Riddick-ulous/DICV3/Firmware/Notes.txt

Datenlogging SPI funktioniert nur bis commit bevor Realtime implementation angefangen hat
