Riddick-ulous/DICV3/Dokumentation/Snipaste_2025-02-16_13-41-41.png

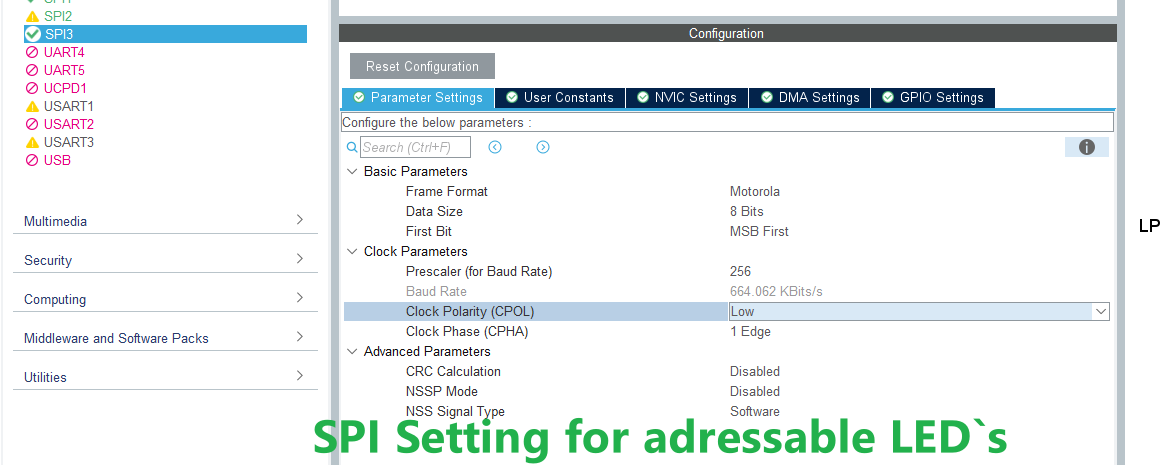
Dokumentation/Snipaste_2025-02-16_13-41-41.png
