Riddick-ulous/DICV3/MCAD/DICMainboard.FCStd

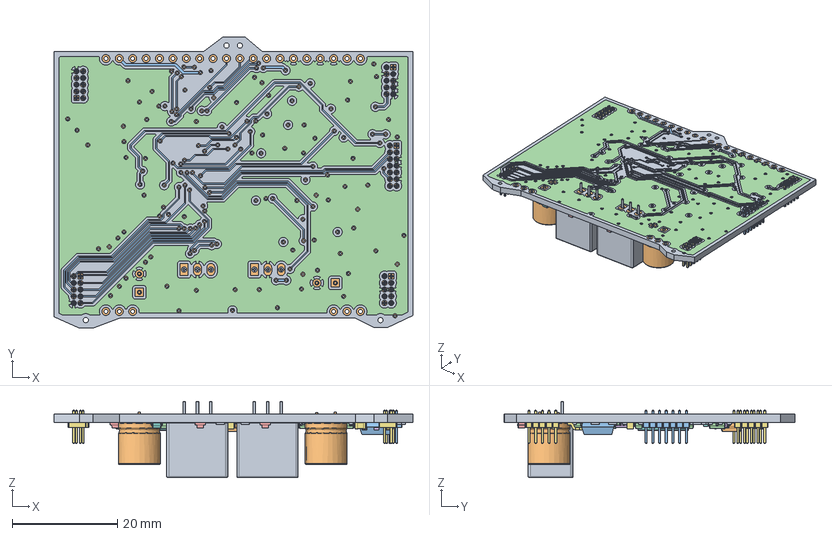
[picture p2: CAD file, 2025-03-25]
MCAD/DICMainboard.FCStd
68.1 x 55.2 x 14.5 mm
Pcb_e9e
topPads_e9e
topTracks_e9e
topZones_e9e
botPads_e9e
botTracks_e9e
C19_C_0805_2012Metric_915db11c73f1 x 11
C18_C_0603_1608Metric_10e447ca614a x 18
R42_R_0603_1608Metric_e00ced120b5b x 47
C21_CP_Radial_D80mm_P350mm_b4bb79b80bd8 x 2
JTAG1_PinHeader_2x07_P127mm_Vertical_7ea92a9874db
U2_SOT_23_5143090a7d01 x 9
12VGood1_LED_0805_2012Metric_2ad75f4ca093 x 5
U10_MSOP_8_3x3mm_P065mm_82bb67e16242 x 2
J3_PinHeader_2x05_P127mm_Vertical_4a0e541a8516 x 4
D10_D_SOD_323_1cf1e5386782 x 7
U1_Converter_DCDC_RECOM_R_78E_05_THT_7495ffbcc0e0 x 2
U7_SOIC_8_39x49mm_P127mm_1499a48e6e93
932d09b3-9c39-11ed-93f0-dde97e994e83_part
932d09b4-9c39-11ed-93f0-dde97e994e83_part
932d09b5-9c39-11ed-93f0-dde97e994e83_part
932d09b5-9c39-11ed-93f0-dde97e994e83_part001
932d09b5-9c39-11ed-93f0-dde97e994e83_part002
U3_LQFP_64_10x10mm_P05mm_ad08613fb525
