Riddick-ulous/DICV3/MCAD/Resources/DIC_Addon.step

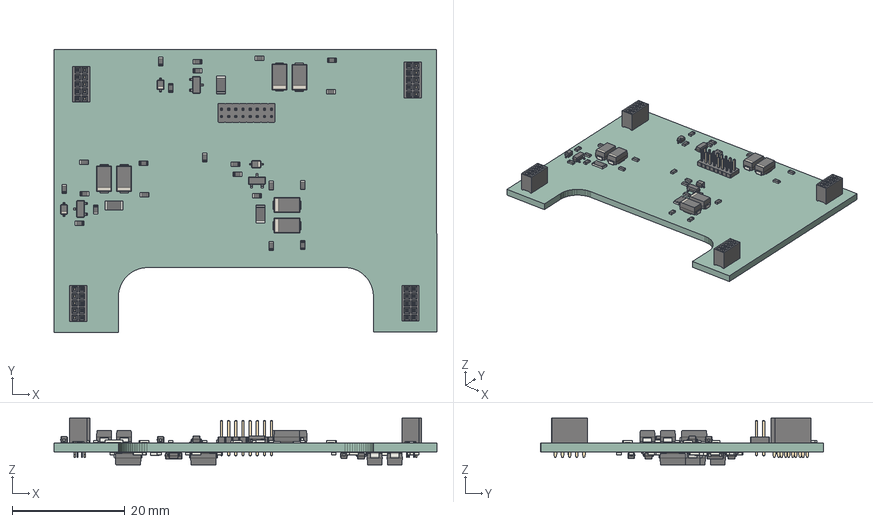
[picture p4: CAD file, 2025-03-25]
MCAD/Resources/DIC_Addon.step
67.9 x 50.3 x 8.32 mm
SOT_23 x 6
D_SOD_323 x 6
PinSocket_2x05_P127mm_Vertical x 4
R_0603_1608Metric x 42
D_SMA x 12
PinHeader_2x08_P127mm_Vertical
R_1206_3216Metric x 6
DIC_Addon PCB
