Riddick-ulous/DICV3/MCAD/ConnectorInterfaceBoard.FCStd

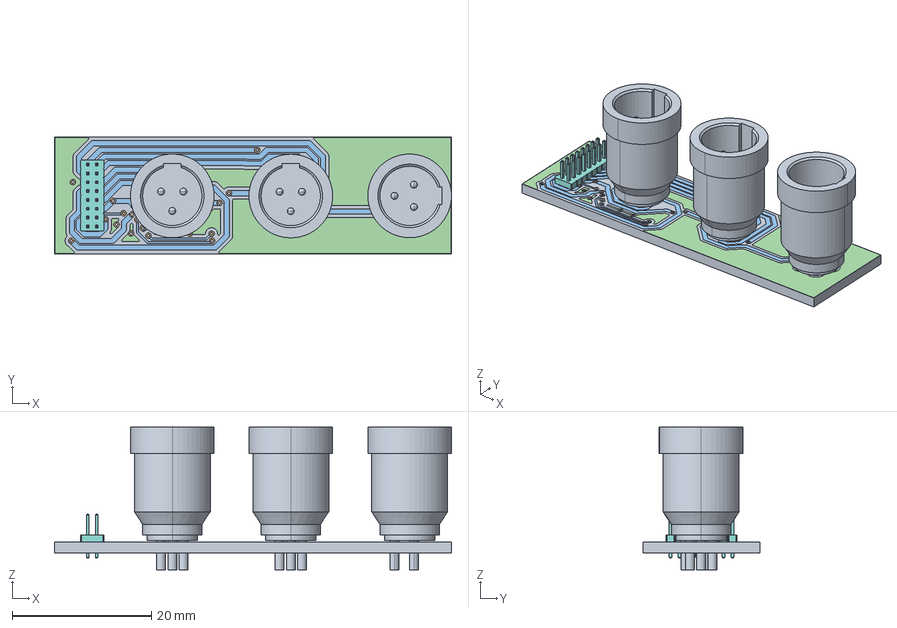
[picture p5: CAD file, 2025-04-17]
MCAD/ConnectorInterfaceBoard.FCStd
56.9 x 16.8 x 20.5 mm
Pcb_5996
topPads_5996
topTracks_5996
topZones_5996
botPads_5996
botTracks_5996
botZones_5996
J4_PinHeader_2x08_P127mm_Vertical_934e7c050846
J1_RT3MP_764b897103e7 x 3
