Riddick-ulous/DICV3/MCAD/Resources/LED_Ring.step

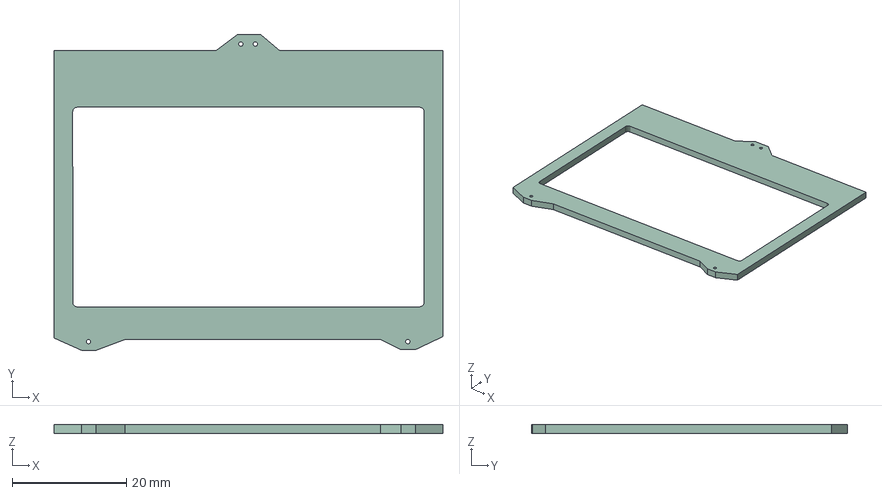
[picture p6: CAD file, 2025-03-22]
MCAD/Resources/LED_Ring.step
68.1 x 55.2 x 1.60 mm
