Riddick-ulous/DICV3/ECAD/DIC_Addon/DIC_Addon2_union.FCStd

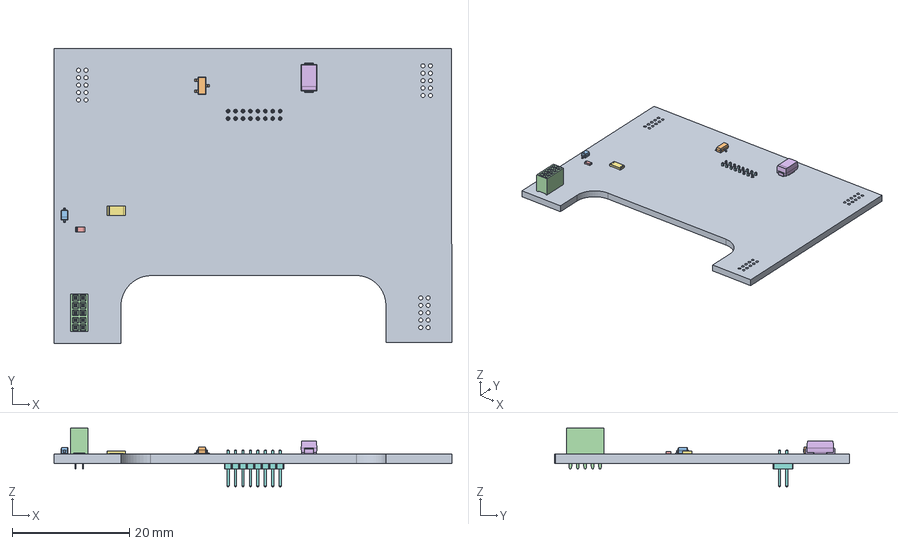
[picture p7: CAD file, 2025-03-25]
ECAD/DIC_Addon/DIC_Addon2_union.FCStd
67.9 x 50.3 x 10.0 mm
Pcb_25db
Q6_SOT_23_ffd5320711a5
D16_D_SOD_323_d7651d96f6c3
J6_PinSocket_2x05_P127mm_Vertical_83ee9fbb584e
R41_R_0603_1608Metric_127fa2614279
D6_D_SMA_735d77270f2b
TH6_R_1206_3216Metric_a4174fc2a386
J3_PinHeader_2x08_P127mm_Vertical_13ff719d442c
