Riddick-ulous/DICV3/MCAD/DICAddonBoard.FCStd

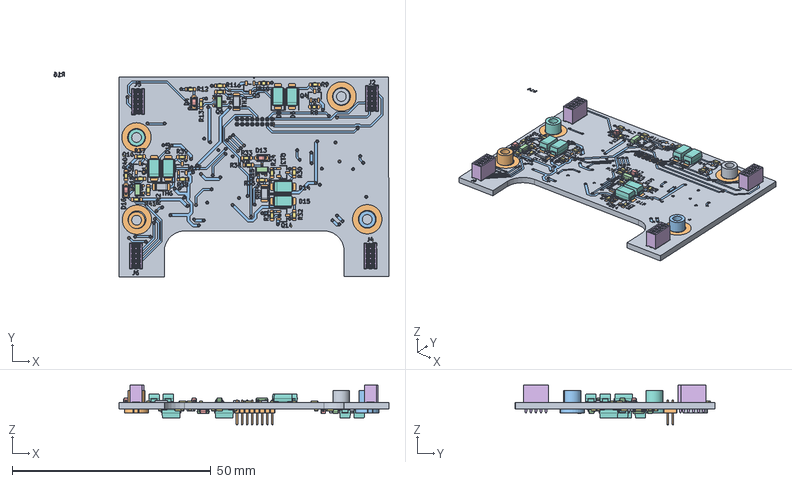
[picture p8: CAD file, 2025-04-17]
MCAD/DICAddonBoard.FCStd
84.2 x 51.5 x 10.0 mm
Pcb_25db
topPads_25db
topTracks_25db
botPads_25db
botTracks_25db
botSilks_c76e
topSilks_caba
Q6_SOT_23_ffd5320711a5 x 6
D16_D_SOD_323_d7651d96f6c3 x 6
J6_PinSocket_2x05_P127mm_Vertical_83ee9fbb584e x 4
R41_R_0603_1608Metric_127fa2614279 x 42
D6_D_SMA_735d77270f2b x 12
TH6_R_1206_3216Metric_a4174fc2a386 x 6
J3_PinHeader_2x08_P127mm_Vertical_13ff719d442c
