Riddick-ulous/DICV3/MCAD/DICDispalyBoard.FCStd

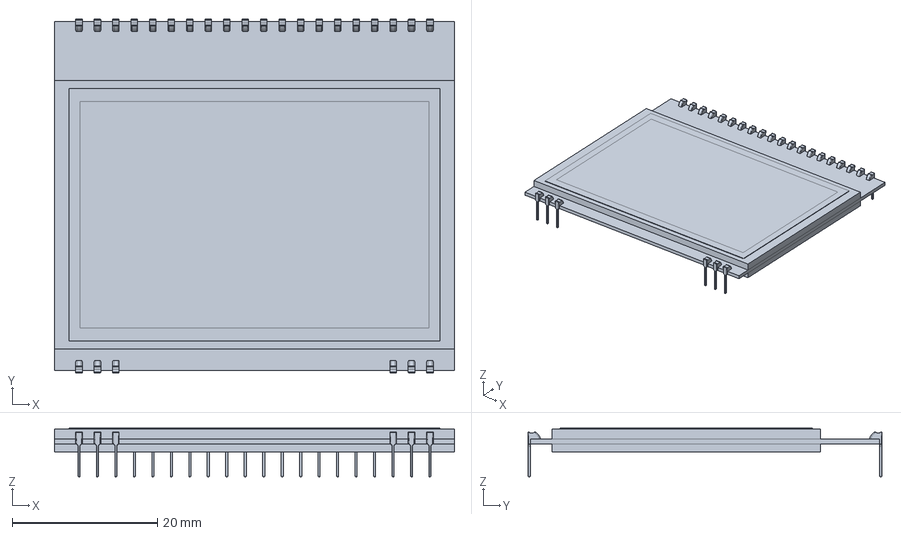
[picture p9: CAD file, 2025-03-22]
MCAD/DICDispalyBoard.FCStd
55.0 x 48.7 x 6.70 mm
