Riddick-ulous/DICV3/(list of files, cad)

Other CAD files:
MCAD/DisplayAssembly.FCStd
ECAD/DIC_Addon/DIC_Addon.step
MCAD/DICLEDBoard.FCStd
ECAD/DIC_Addon/DIC_Addon.FCStd
ECAD/DIC_Addon/DIC_Addon1.FCStd
