Riddick-ulous/DICV3/Dokumentation/AnalogFrontend.asc

C1: cap; 160n
C2: cap; 160n
D1: schottky; BAT54
D2: schottky; BAT54
Q1: npn
Q2: npn
Q3: npn
Q4: npn
R1: res; 82k
R2: res; 150k
R3: res; 39k
R4: res; 1k
R5: res; 100
R6: res; 100
R7: res; 100
R8: res; 6800
R9: res; 2.2Mega
R10: res; 82k
R11: res; 150k
R12: res; 1k
R13: res; 39k
R14: res; 100
R15: res; 100
R16: res; 100
R17: res; 2.2Mega
R18: res; 5k
R19: res; 5k
U1: ADA4500
U2: ADA4500
V1: voltage; 5
V2: voltage; -5
V3: voltage; 12
V4: voltage; 3.3
V5: voltage; 3.3
V6: voltage; 3.3
V7: voltage; 5
V8: voltage; -5
V9: voltage; 3.3
V10: voltage; 3.3
V11: voltage; 3.3
V12: voltage; SINE(6 6 1000)
V13: voltage; 0
V14: voltage; 3.3
Named nets: 0
.tran 0.005
