Riddick-ulous/DICV3/ECAD/DIC/DIC.kicad_pcb

## KiCad design ECAD/DIC/DIC.kicad_pcb (2025-06-22)

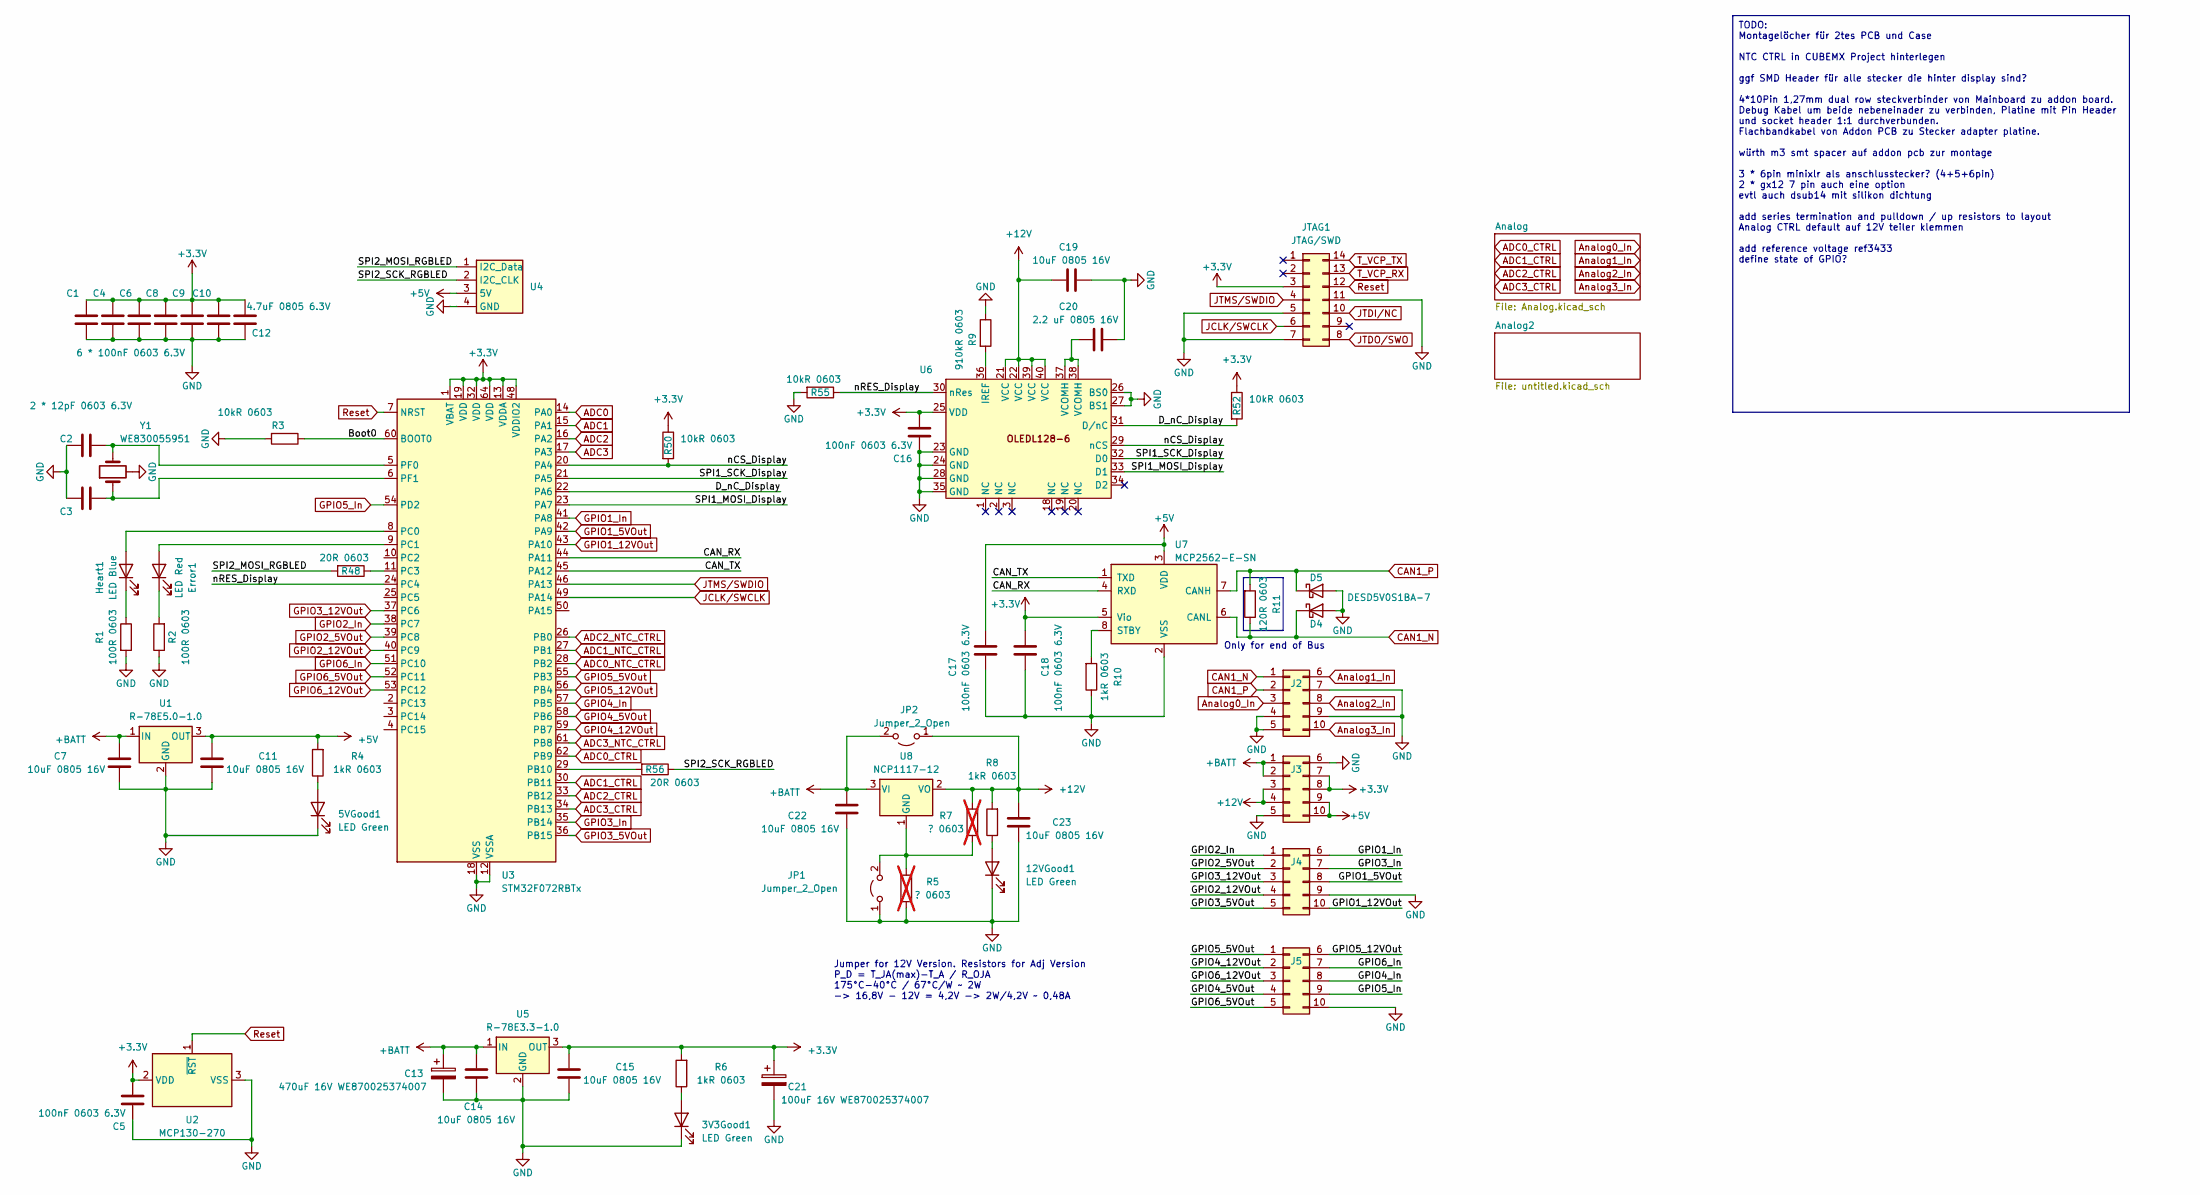
[picture p10: schematic DIC.kicad_sch]

Parts:
3V3Good1, 5VGood1, 12VGood1: LED Green; LED_0805_2012Metric_Pad1.15x1.40mm_HandSolder
C1, C4, C5, C6, C8, C10, C16, C17, C18: 100nF 0603 6.3V; C_0603_1608Metric_Pad1.08x0.95mm_HandSolder
C2: 12pF 0603 6.3V; C_0603_1608Metric_Pad1.08x0.95mm_HandSolder
C3: 2 * 12pF 0603 6.3V; C_0603_1608Metric_Pad1.08x0.95mm_HandSolder
C7, C11, C14, C15, C19, C22, C23: 10uF 0805 16V; C_0805_2012Metric_Pad1.18x1.45mm_HandSolder
C9: 6 * 100nF 0603 6.3V; C_0603_1608Metric_Pad1.08x0.95mm_HandSolder
C12: 4.7uF 0805 6.3V; C_0805_2012Metric_Pad1.18x1.45mm_HandSolder
C13: 470uF 16V WE870025374007; CP_Radial_D8.0mm_P3.50mm
C20: 2.2 uF 0805 16V; C_0805_2012Metric_Pad1.18x1.45mm_HandSolder
C21: 100uF 16V WE870025374007; CP_Radial_D8.0mm_P3.50mm
D4, D5: DESD5V0S1BA-7; D_SOD-323
Error1: LED Red; LED_0805_2012Metric_Pad1.15x1.40mm_HandSolder
Heart1: LED Blue; LED_0805_2012Metric_Pad1.15x1.40mm_HandSolder
J2, J3, J4, J5: Conn_02x05_Top_Bottom; PinHeader_2x05_P1.27mm_Vertical
JP1, JP2: Jumper_2_Open; SolderJumper-2_P1.3mm_Open_RoundedPad1.0x1.5mm
JTAG1: JTAG/SWD; PinHeader_2x07_P1.27mm_Vertical
R1, R2: 100R 0603; R_0603_1608Metric_Pad0.98x0.95mm_HandSolder
R3, R50, R52, R55: 10kR 0603; R_0603_1608Metric_Pad0.98x0.95mm_HandSolder
R4, R6, R8, R10: 1kR 0603; R_0603_1608Metric_Pad0.98x0.95mm_HandSolder
R5, R7: ? 0603; R_0603_1608Metric_Pad0.98x0.95mm_HandSolder; not fitted
R9: 910kR 0603; R_0603_1608Metric_Pad0.98x0.95mm_HandSolder
R11: 120R 0603; R_0603_1608Metric_Pad0.98x0.95mm_HandSolder
R48, R56: 20R 0603; R_0603_1608Metric_Pad0.98x0.95mm_HandSolder
U1: R-78E5.0-1.0; Converter_DCDC_RECOM_R-78E-0.5_THT
U2: MCP130-270; SOT-23
U3: STM32F072RBTx; LQFP-64_10x10mm_P0.5mm
U4: LED_Ring
U5: R-78E3.3-1.0; Converter_DCDC_RECOM_R-78E-0.5_THT
U6: EA OLEDL128-6
U7: MCP2562-E-SN; SOIC-8_3.9x4.9mm_P1.27mm
U8: NCP1117-12; TO-252-2
Y1: WE830055951; Oscillator_SMD_EuroQuartz_XO32-4Pin_3.2x2.5mm_HandSoldering

Connections:
+3.3V: C1.1, C4.1, C5.2, C6.1, C8.1, C9.1, C10.1, C12.1, C15.1, C16.2, C18.2, C21.1, J3.7, J3.8, JTAG1.3, R6.2, R50.1, R52.1, U2.2 (VDD), U3.1 (VBAT), U3.13 (VDDA), U3.19 (VDD), U3.32 (VDD), U3.48 (VDDIO2), U3.64 (VDD), U5.3 (OUT), U6.25 (VDD), U7.5 (Vio); also elsewhere on the board
+5V: C11.1, C17.2, J3.9, J3.10, R4.2, U1.3 (OUT), U4.3 (5V), U7.3 (VDD); also elsewhere on the board
+12V: C19.2, C23.1, J3.3, J3.4, JP2.1 (A), R7.2, R8.2, U6.21 (VCC), U6.22 (VCC), U6.39 (VCC), U6.40 (VCC), U8.2 (VO)
+BATT: C7.1, C13.1, C14.1, C22.1, J3.1, J3.2, JP2.2 (B), U1.1 (IN), U5.1 (IN), U8.3 (VI)
/Boot0: R3.1, U3.60 (BOOT0)
/CAN_RX: U3.44 (PA11), U7.4 (RXD)
/CAN_TX: U3.45 (PA12), U7.1 (TXD)
/D_nC_Display: R52.2, U3.22 (PA6), U6.31 (D/nC)
/SPI1_MOSI_Display: U3.23 (PA7), U6.33 (D1)
/SPI1_SCK_Display: U3.21 (PA5), U6.32 (D0)
/SPI2_MOSI_RGBLED: R48.2, U4.1 (I2C_Data)
/SPI2_SCK_RGBLED: R56.1, U4.2 (I2C_CLK)
/nCS_Display: R50.2, U3.20 (PA4), U6.29 (nCS)
/nRES_Display: R55.1, U3.24 (PC4), U6.30 (nRes)
ADC0: U3.14 (PA0); also elsewhere on the board
ADC0_CTRL: U3.62 (PB9); also elsewhere on the board
ADC0_NTC_CTRL: U3.28 (PB2); also elsewhere on the board
ADC1: U3.15 (PA1); also elsewhere on the board
ADC1_CTRL: U3.30 (PB11); also elsewhere on the board
ADC1_NTC_CTRL: U3.27 (PB1); also elsewhere on the board
ADC2: U3.16 (PA2); also elsewhere on the board
ADC2_CTRL: U3.33 (PB12); also elsewhere on the board
ADC2_NTC_CTRL: U3.26 (PB0); also elsewhere on the board
ADC3: U3.17 (PA3); also elsewhere on the board
ADC3_CTRL: U3.34 (PB13); also elsewhere on the board
ADC3_NTC_CTRL: U3.61 (PB8); also elsewhere on the board
Analog0_In: J2.3; also elsewhere on the board
Analog1_In: J2.6; also elsewhere on the board
Analog2_In: J2.8; also elsewhere on the board
Analog3_In: J2.10; also elsewhere on the board
CAN1_N: D4.1 (K), J2.1, R11.1, U7.6 (CANL)
CAN1_P: D5.1 (K), J2.2, R11.2, U7.7 (CANH)
GND: 3V3Good1.1 (K), 5VGood1.1 (K), 12VGood1.1 (K), C1.2, C2.1, C3.1, C4.2, C5.1, C6.2, C7.2, C8.2, C9.2, C10.2, C11.2, C12.2, C13.2, C14.2, C15.2, C16.1, C17.1, C18.1, C19.1, C20.1, C21.2, C22.2, C23.2, D4.2 (A), D5.2 (A), J2.4, J2.5, J2.7, J2.9, J3.5, J3.6, J4.9, J5.10, JP1.1 (A), JTAG1.5, JTAG1.7, JTAG1.11, R1.2, R2.1, R3.2, R5.1, R9.1, R10.1, R55.2, U1.2 (GND), U2.3 (VSS), U3.12 (VSSA), U3.18 (VSS), U3.31 (VSS), U3.47 (VSS), U3.63 (VSS), U4.4 (GND), U5.2 (GND), U6.23 (GND), U6.24 (GND), U6.26 (BS0), U6.27 (BS1), U6.28 (GND), U6.35 (GND), U7.2 (VSS), Y1.2 (2_GND), Y1.4 (4_GND); also elsewhere on the board
GPIO1_5VOut: J4.8, U3.42 (PA9)
GPIO1_12VOut: J4.10, U3.43 (PA10)
GPIO1_In: J4.6, U3.41 (PA8)
GPIO2_5VOut: J4.2, U3.39 (PC8)
GPIO2_12VOut: J4.4, U3.40 (PC9)
GPIO2_In: J4.1, U3.38 (PC7)
GPIO3_5VOut: J4.5, U3.36 (PB15)
GPIO3_12VOut: J4.3, U3.37 (PC6)
GPIO3_In: J4.7, U3.35 (PB14)
GPIO4_5VOut: J5.4, U3.58 (PB6)
GPIO4_12VOut: J5.2, U3.59 (PB7)
GPIO4_In: J5.8, U3.57 (PB5)
GPIO5_5VOut: J5.1, U3.55 (PB3)
GPIO5_12VOut: J5.6, U3.56 (PB4)
GPIO5_In: J5.9, U3.54 (PD2)
GPIO6_5VOut: J5.5, U3.52 (PC11)
GPIO6_12VOut: J5.3, U3.53 (PC12)
GPIO6_In: J5.7, U3.51 (PC10)
JCLK/SWCLK: JTAG1.6, U3.49 (PA14)
JTDI/NC: JTAG1.10
JTDO/SWO: JTAG1.8
JTMS/SWDIO: JTAG1.4, U3.46 (PA13)
unnamed: 3V3Good1.2 (A), R6.1
unnamed: 5VGood1.2 (A), R4.1
unnamed: 12VGood1.2 (A), R8.1
unnamed: C20.2, U6.37 (VCOMH), U6.38 (VCOMH)
unnamed: Error1.2 (A), U3.9 (PC1)
unnamed: Error1.1 (K), R2.2
unnamed: Heart1.2 (A), U3.8 (PC0)
unnamed: Heart1.1 (K), R1.1
unnamed: JP1.2 (B), R5.2, R7.1, U8.1 (GND)
unnamed: R56.2, U3.29 (PB10)
unnamed: R48.1, U3.11 (PC3)
unnamed: C2.2, U3.5 (PF0), Y1.3 (3_Crystal)
unnamed: C3.2, U3.6 (PF1), Y1.1 (1_Crystal)
unnamed: R9.2, U6.36 (IREF)
unnamed: R10.2, U7.8 (STBY)
Reset: JTAG1.12, U2.1 (~RST), U3.7 (NRST)
T_VCP_RX: JTAG1.13
T_VCP_TX: JTAG1.14

Notes on the sheet:
TODO: Montagelöcher für 2tes PCB und Case NTC CTRL in CUBEMX Project hinterlegen ggf SMD Header für alle stecker die hinter display sind? 4*10Pin 1,27mm dual row steckverbinder von Mainboard zu addon board. Debug Kabel um beide nebeneinader zu verbinden, Platine mit Pin Header und socket header 1:1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
Only for end of Bus
Jumper for 12V Version. Resistors for Adj Version P_D = T_JA(max)-T_A / R_OJA 175°C-40°C / 67°C/W ~ 2W -> 16,8V - 12V = 4,2V -> 2W/4,2V ~ 0,48A

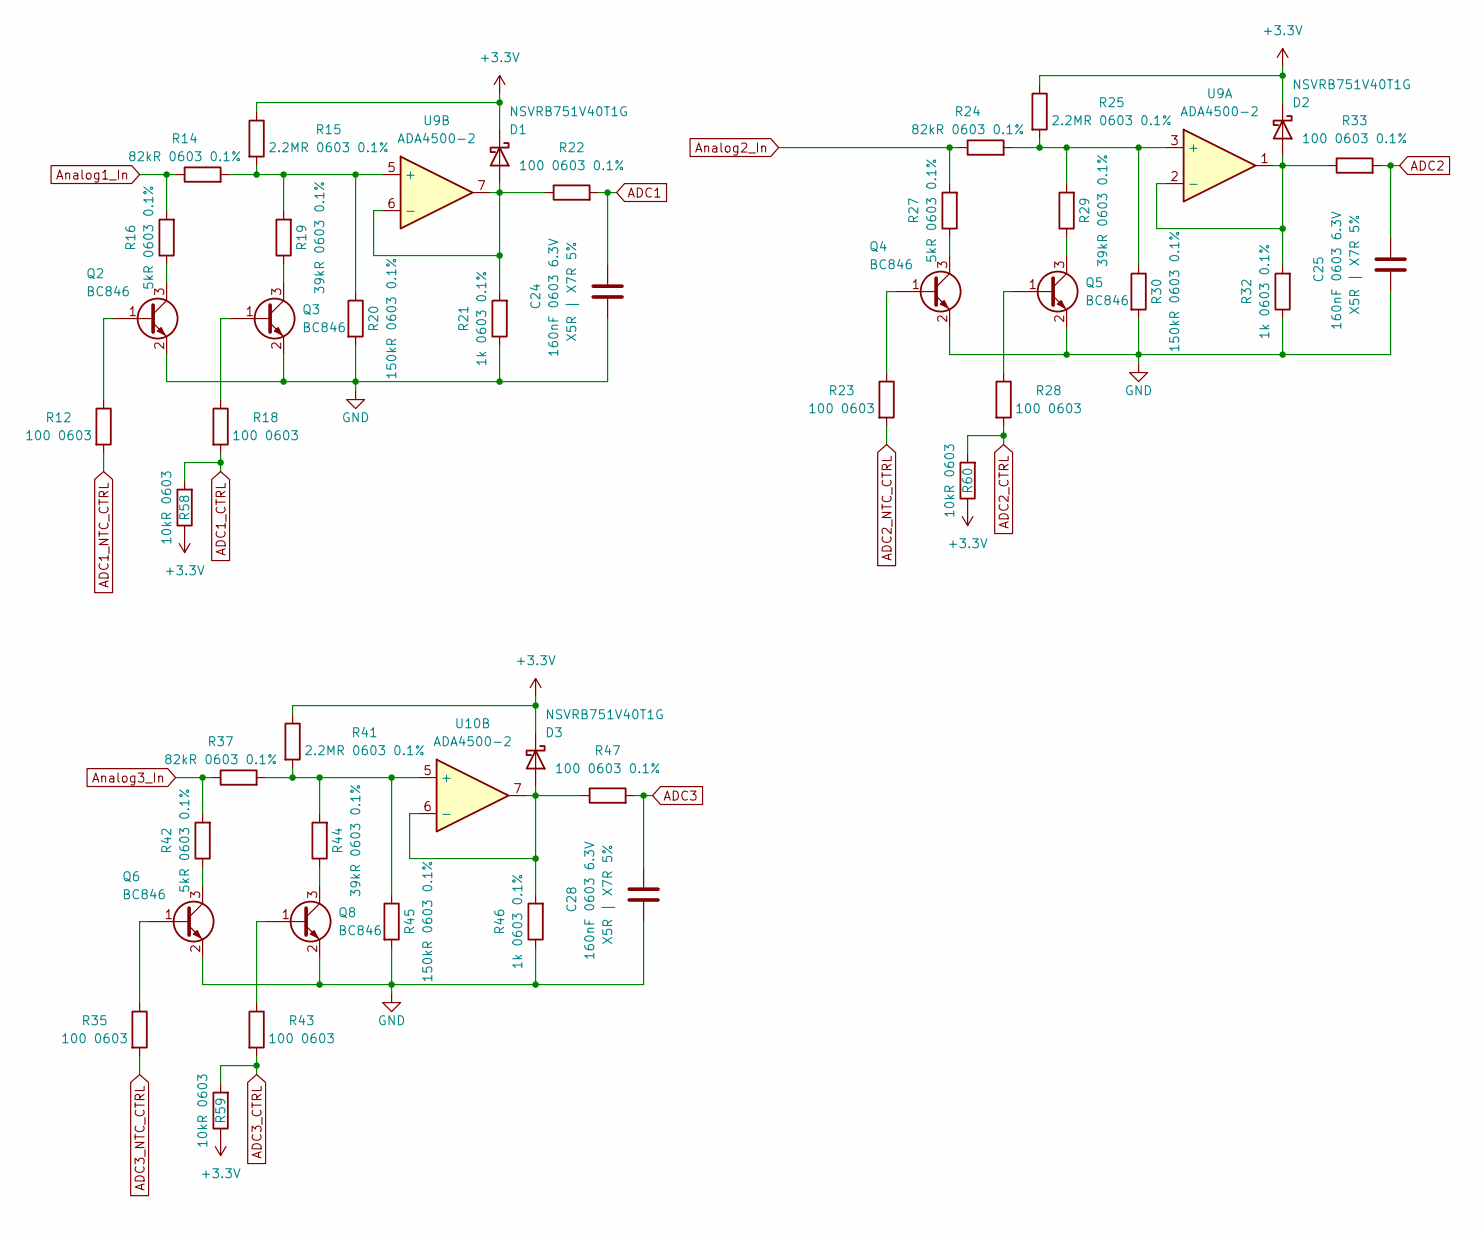
[picture p11: schematic untitled.kicad_sch]

Parts:
C24, C25, C28: 160nF 0603 6.3V; C_0603_1608Metric_Pad1.08x0.95mm_HandSolder; PartNr. VJ0603Y223JXJAC
D1, D2, D3: NSVRB751V40T1G; D_SOD-323_HandSoldering; PartNr. NSVRB751V40T1G
Q2, Q3, Q4, Q5, Q6, Q8: BC846; SOT-23
R12, R18, R23, R28, R35, R43: 100 0603; R_0603_1608Metric_Pad0.98x0.95mm_HandSolder
R14, R24, R37: 82kR 0603 0.1%; R_0603_1608Metric_Pad0.98x0.95mm_HandSolder
R15, R25, R41: 2.2MR 0603 0.1%; R_0603_1608Metric_Pad0.98x0.95mm_HandSolder
R16, R27, R42: 5kR 0603 0.1%; R_0603_1608Metric_Pad0.98x0.95mm_HandSolder
R19, R29, R44: 39kR 0603 0.1%; R_0603_1608Metric_Pad0.98x0.95mm_HandSolder
R20, R30, R45: 150kR 0603 0.1%; R_0603_1608Metric_Pad0.98x0.95mm_HandSolder
R21, R32, R46: 1k 0603 0.1%; R_0603_1608Metric_Pad0.98x0.95mm_HandSolder
R22, R33, R47: 100 0603 0.1%; R_0603_1608Metric_Pad0.98x0.95mm_HandSolder
R58, R59, R60: 10kR 0603; R_0603_1608Metric_Pad0.98x0.95mm_HandSolder
U9, U10: ADA4500-2; MSOP-8_3x3mm_P0.65mm

Connections:
+3.3V: D1.1 (K), D2.1 (K), D3.1 (K), R15.1, R25.1, R41.1, R58.1, R59.1, R60.1; also elsewhere on the board
ADC1: C24.2, R22.2; also elsewhere on the board
ADC1_CTRL: R18.2, R58.2; also elsewhere on the board
ADC1_NTC_CTRL: R12.2; also elsewhere on the board
ADC2: C25.2, R33.2; also elsewhere on the board
ADC2_CTRL: R28.2, R60.2; also elsewhere on the board
ADC2_NTC_CTRL: R23.2; also elsewhere on the board
ADC3: C28.2, R47.2; also elsewhere on the board
ADC3_CTRL: R43.2, R59.2; also elsewhere on the board
ADC3_NTC_CTRL: R35.2; also elsewhere on the board
Analog1_In: R14.1, R16.2; also elsewhere on the board
Analog2_In: R24.1, R27.2; also elsewhere on the board
Analog3_In: R37.1, R42.2; also elsewhere on the board
GND: C24.1, C25.1, C28.1, Q2.2 (E), Q3.2 (E), Q4.2 (E), Q5.2 (E), Q6.2 (E), Q8.2 (E), R20.2, R21.1, R30.2, R32.1, R45.2, R46.1; also elsewhere on the board
unnamed: D1.2 (A), R21.2, R22.1, U9.6 (-), U9.7
unnamed: D2.2 (A), R32.2, R33.1, U9.1, U9.2 (-)
unnamed: D3.2 (A), R46.2, R47.1, U10.6 (-), U10.7
unnamed: Q2.1 (B), R12.1
unnamed: Q2.3 (C), R16.1
unnamed: Q3.1 (B), R18.1
unnamed: Q3.3 (C), R19.1
unnamed: Q4.1 (B), R23.1
unnamed: Q4.3 (C), R27.1
unnamed: Q5.1 (B), R28.1
unnamed: Q5.3 (C), R29.1
unnamed: Q6.1 (B), R35.1
unnamed: Q6.3 (C), R42.1
unnamed: Q8.1 (B), R43.1
unnamed: Q8.3 (C), R44.1
unnamed: R24.2, R25.2, R29.2, R30.1, U9.3 (+)
unnamed: R14.2, R15.2, R19.2, R20.1, U9.5 (+)
unnamed: R37.2, R41.2, R44.2, R45.1, U10.5 (+)

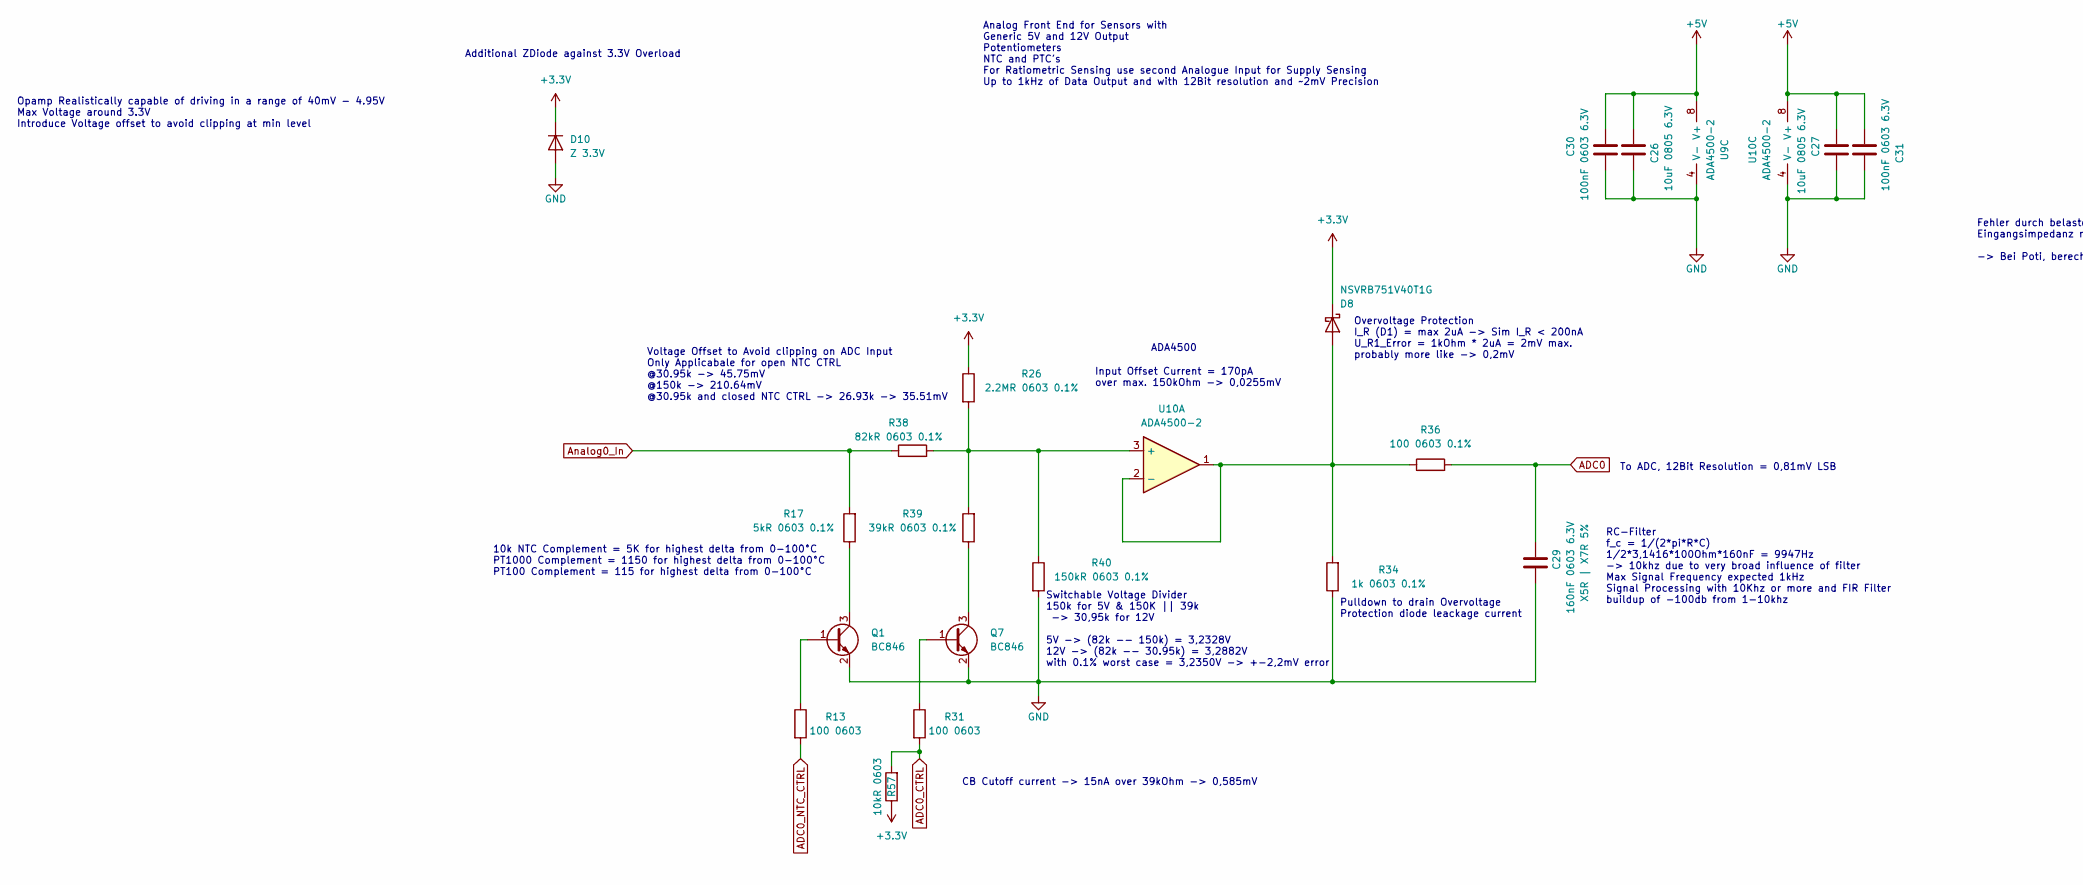
[picture p12: schematic Analog.kicad_sch, part in row 1, column 1]

Parts:
C26, C27: 10uF 0805 6.3V; C_0805_2012Metric_Pad1.18x1.45mm_HandSolder
C29: 160nF 0603 6.3V; C_0603_1608Metric_Pad1.08x0.95mm_HandSolder; PartNr. VJ0603Y223JXJAC
C30, C31: 100nF 0603 6.3V; C_0603_1608Metric_Pad1.08x0.95mm_HandSolder
D8: NSVRB751V40T1G; D_SOD-323_HandSoldering; PartNr. NSVRB751V40T1G
D10: Z 3.3V; D_SOD-323_HandSoldering; PartNr. MM3Z3V3T1G
Q1, Q7: BC846; SOT-23
R13, R31: 100 0603; R_0603_1608Metric_Pad0.98x0.95mm_HandSolder
R17: 5kR 0603 0.1%; R_0603_1608Metric_Pad0.98x0.95mm_HandSolder
R26: 2.2MR 0603 0.1%; R_0603_1608Metric_Pad0.98x0.95mm_HandSolder
R34: 1k 0603 0.1%; R_0603_1608Metric_Pad0.98x0.95mm_HandSolder
R36: 100 0603 0.1%; R_0603_1608Metric_Pad0.98x0.95mm_HandSolder
R38: 82kR 0603 0.1%; R_0603_1608Metric_Pad0.98x0.95mm_HandSolder
R39: 39kR 0603 0.1%; R_0603_1608Metric_Pad0.98x0.95mm_HandSolder
R40: 150kR 0603 0.1%; R_0603_1608Metric_Pad0.98x0.95mm_HandSolder
R57: 10kR 0603; R_0603_1608Metric_Pad0.98x0.95mm_HandSolder
U9, U10: ADA4500-2; MSOP-8_3x3mm_P0.65mm

Connections:
+3.3V: D8.1 (K), D10.1 (K), R26.1, R57.1; also elsewhere on the board
+5V: C26.1, C27.2, C30.2, C31.1, U9.8 (V+), U10.8 (V+); also elsewhere on the board
ADC0: C29.2, R36.2; also elsewhere on the board
ADC0_CTRL: R31.2, R57.2; also elsewhere on the board
ADC0_NTC_CTRL: R13.2; also elsewhere on the board
Analog0_In: R17.2, R38.1; also elsewhere on the board
GND: C26.2, C27.1, C29.1, C30.1, C31.2, D10.2 (A), Q1.2 (E), Q7.2 (E), R34.1, R40.2, U9.4 (V-), U10.4 (V-); also elsewhere on the board
unnamed: D8.2 (A), R34.2, R36.1, U10.1, U10.2 (-)
unnamed: Q1.1 (B), R13.1
unnamed: Q1.3 (C), R17.1
unnamed: Q7.1 (B), R31.1
unnamed: Q7.3 (C), R39.1
unnamed: R26.2, R38.2, R39.2, R40.1, U10.3 (+)

Notes on the sheet:
ADA4500
To ADC, 12Bit Resolution = 0,81mV LSB
CB Cutoff current -> 15nA over 39kOhm -> 0,585mV
Analog Front End for Sensors with Generic 5V and 12V Output Potentiometers NTC and PTC's For Ratiometric Sensing use second Analogue Input for Supply Sensing Up to 1kHz of Data Output and with 12Bit resolution and ~2mV Precision
Input Offset Current = 170pA over max. 150kOhm -> 0,0255mV
Overvoltage Protection I_R (D1) = max 2uA -> Sim I_R < 200nA U_R1_Error = 1kOhm * 2uA = 2mV max. probably more like -> 0,2mV
Pulldown to drain Overvoltage Protection diode leackage current
Switchable Voltage Divider 150k for 5V & 150K || 39k -> 30,95k for 12V 5V -> (82k -- 150k) = 3,2328V 12V -> (82k -- 30.95k) = 3,2882V with 0.1% worst case = 3,2350V -> +-2,2mV error
Additional ZDiode against 3.3V Overload
Opamp Realistically capable of driving in a range of 40mV - 4.95V Max Voltage around 3.3V Introduce Voltage offset to avoid clipping at min level
Voltage Offset to Avoid clipping on ADC Input Only Applicabale for open NTC CTRL @30.95k -> 45.75mV @150k -> 210.64mV @30.95k and closed NTC CTRL -> 26.93k -> 35.51mV
10k NTC Complement = 5K for highest delta from 0-100°C PT1000 Complement = 1150 for highest delta from 0-100°C PT100 Complement = 115 for highest delta from 0-100°C
Fehler durch belasteten spannungsteiler idr so groß das ohne impedanzwandler nicht praktikabel. Eingangsimpedanz muss bei 500k und größer liegen damit der Messfehler hinreichend klein wird. -> Bei Poti, berechung des Eingangswertes nur über belasteten spannungsteiler!!!
Abweichung durch belasteten SPannungsteiler so groß, das Dimensionierung der Eingangsimoedanz in bezug auf andere Abweichungsmechanismen nicht praktikabel -> Auswertung von Potis in SW nur über belasteten SPannungsteiler
RC-Filter f_c = 1/(2*pi*R*C) 1/2*3,1416*100Ohm*160nF = 9947Hz -> 10khz due to very broad influence of filter Max Signal Frequency expected 1kHz Signal Processing with 10Khz or more and FIR Filter buildup of -100db from 1-10khz

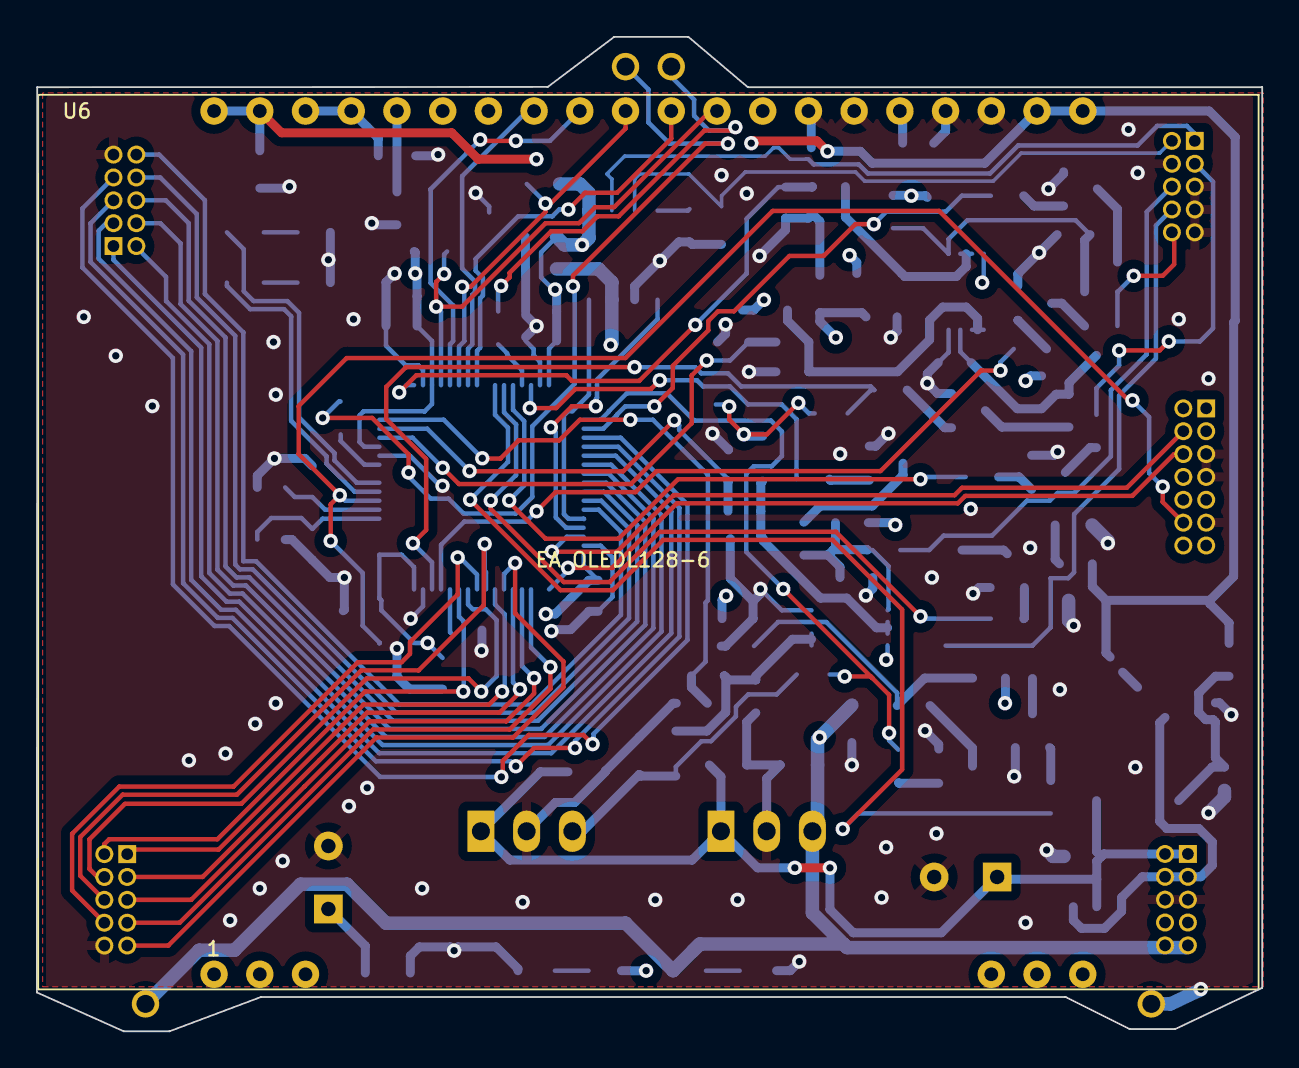
[picture p13: board DIC.kicad_pcb from above]

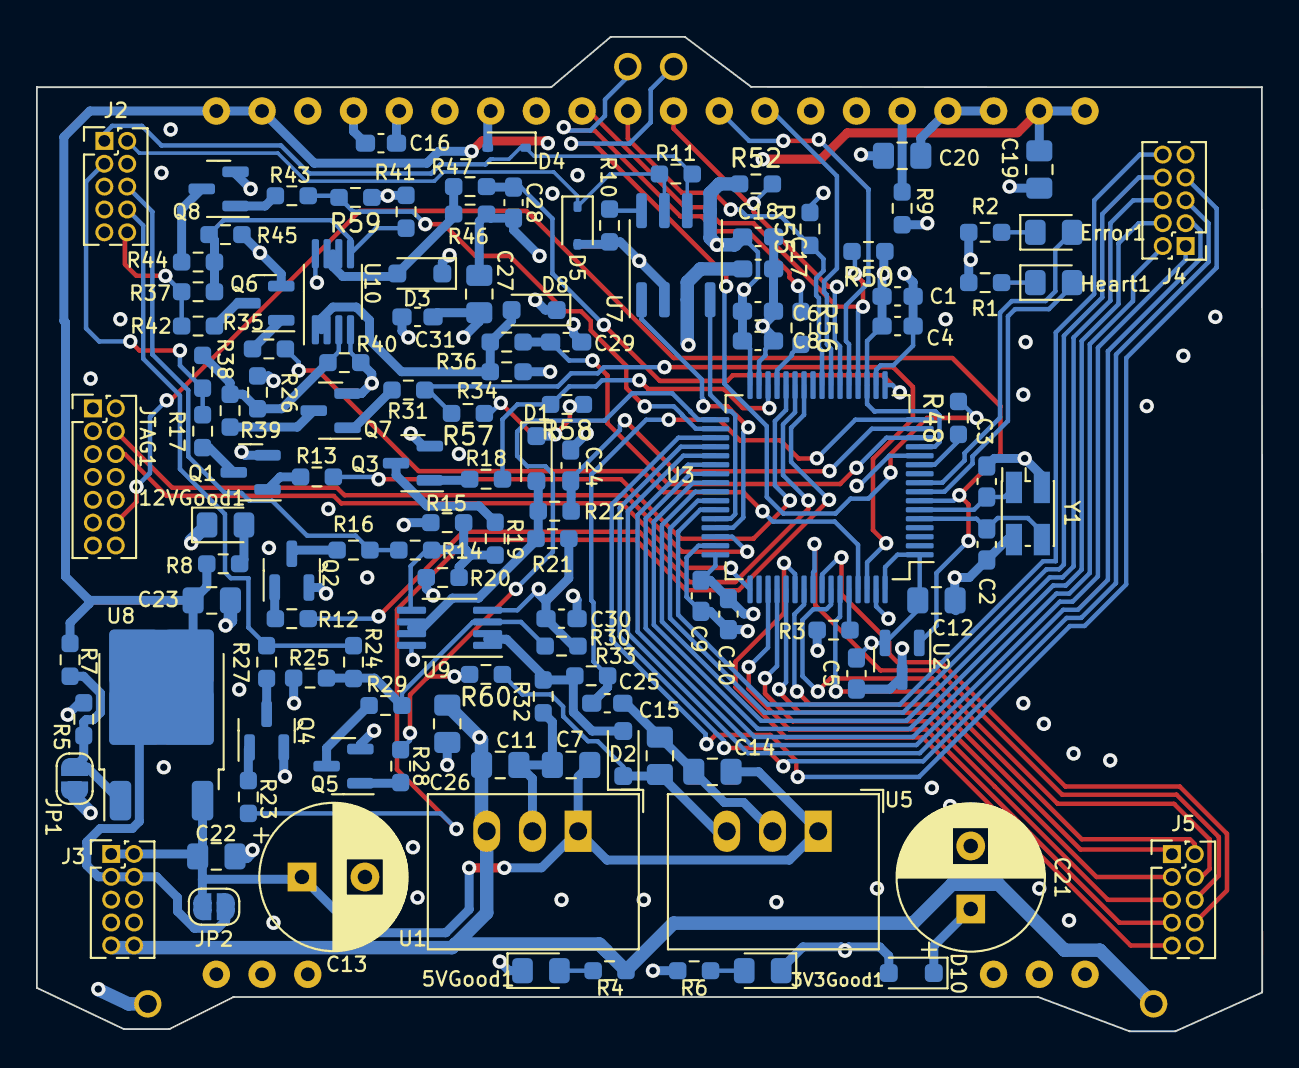
[picture p14: board DIC.kicad_pcb from below]

Board: 4 copper layers, 68.1 x 55.2 mm, 125 parts (123 on the bottom side), 93 nets.
