Riddick-ulous/DICV3/ECAD/ConnectorIntefaceBoard/ConnectorInterfaceBoard/ConnectorInterfaceBoard.kicad_pcb

## KiCad design ECAD/ConnectorIntefaceBoard/ConnectorInterfaceBoard/ConnectorInterfaceBoard.kicad_pcb (2025-06-22)

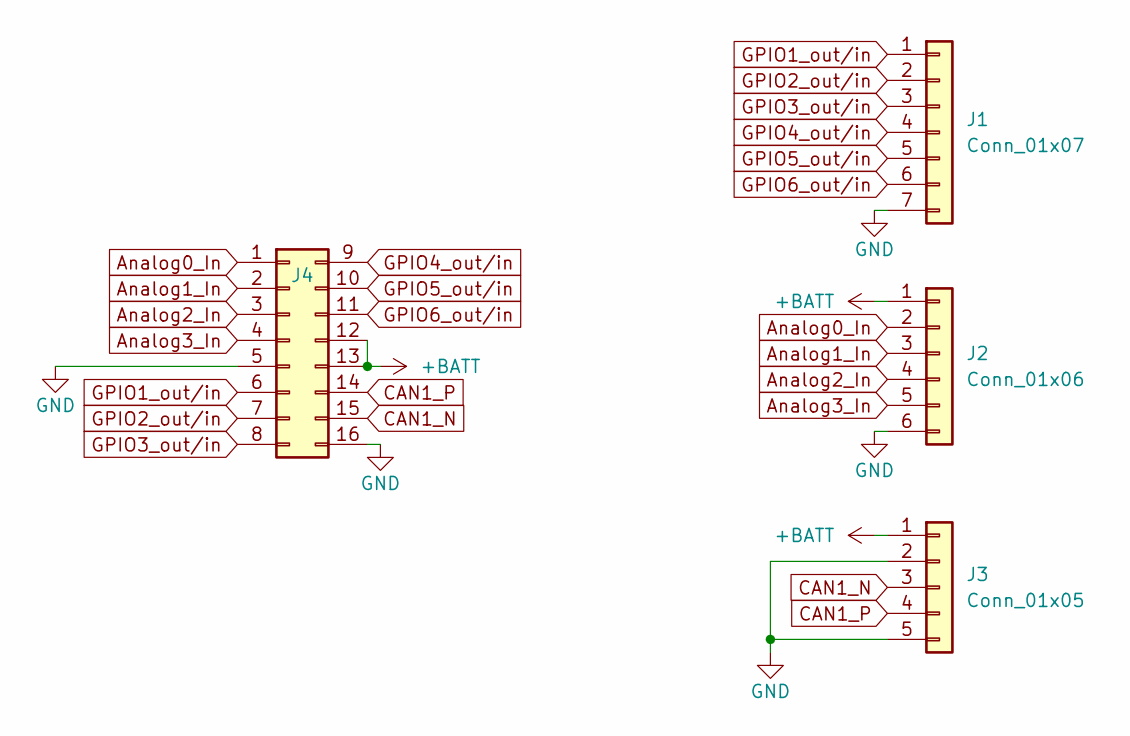
[picture p15: schematic ConnectorInterfaceBoard.kicad_sch]

Parts:
J1: Conn_01x07; MiniXLR_7Pin
J2: Conn_01x06; MiniXLR_6Pin
J3: Conn_01x05; MiniXLR_5Pin
J4: WE 62702621621; PinHeader_2x08_P1.27mm_Vertical

Connections:
+BATT: J2.1, J3.1, J4.12, J4.13
Analog0_In: J2.2, J4.1
Analog1_In: J2.3, J4.2
Analog2_In: J2.4, J4.3
Analog3_In: J2.5, J4.4
CAN1_N: J3.3, J4.15
CAN1_P: J3.4, J4.14
GND: J1.7, J2.6, J3.2, J3.5, J4.5, J4.16
GPIO1_out/in: J1.1, J4.6
GPIO2_out/in: J1.2, J4.7
GPIO3_out/in: J1.3, J4.8
GPIO4_out/in: J1.4, J4.9
GPIO5_out/in: J1.5, J4.10
GPIO6_out/in: J1.6, J4.11

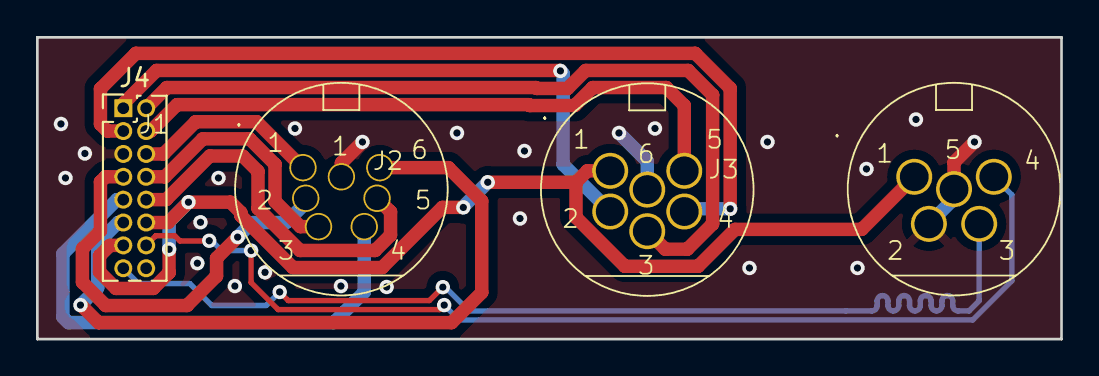
[picture p16: board ConnectorInterfaceBoard.kicad_pcb from above]

Board: 2 copper layers, 56.9 x 16.8 mm, 4 parts (0 on the bottom side), 14 nets.
