Riddick-ulous/DICV3/ECAD/DIC_Addon/DIC_Addon.kicad_pcb

## KiCad design ECAD/DIC_Addon/DIC_Addon.kicad_pcb (2025-06-22)

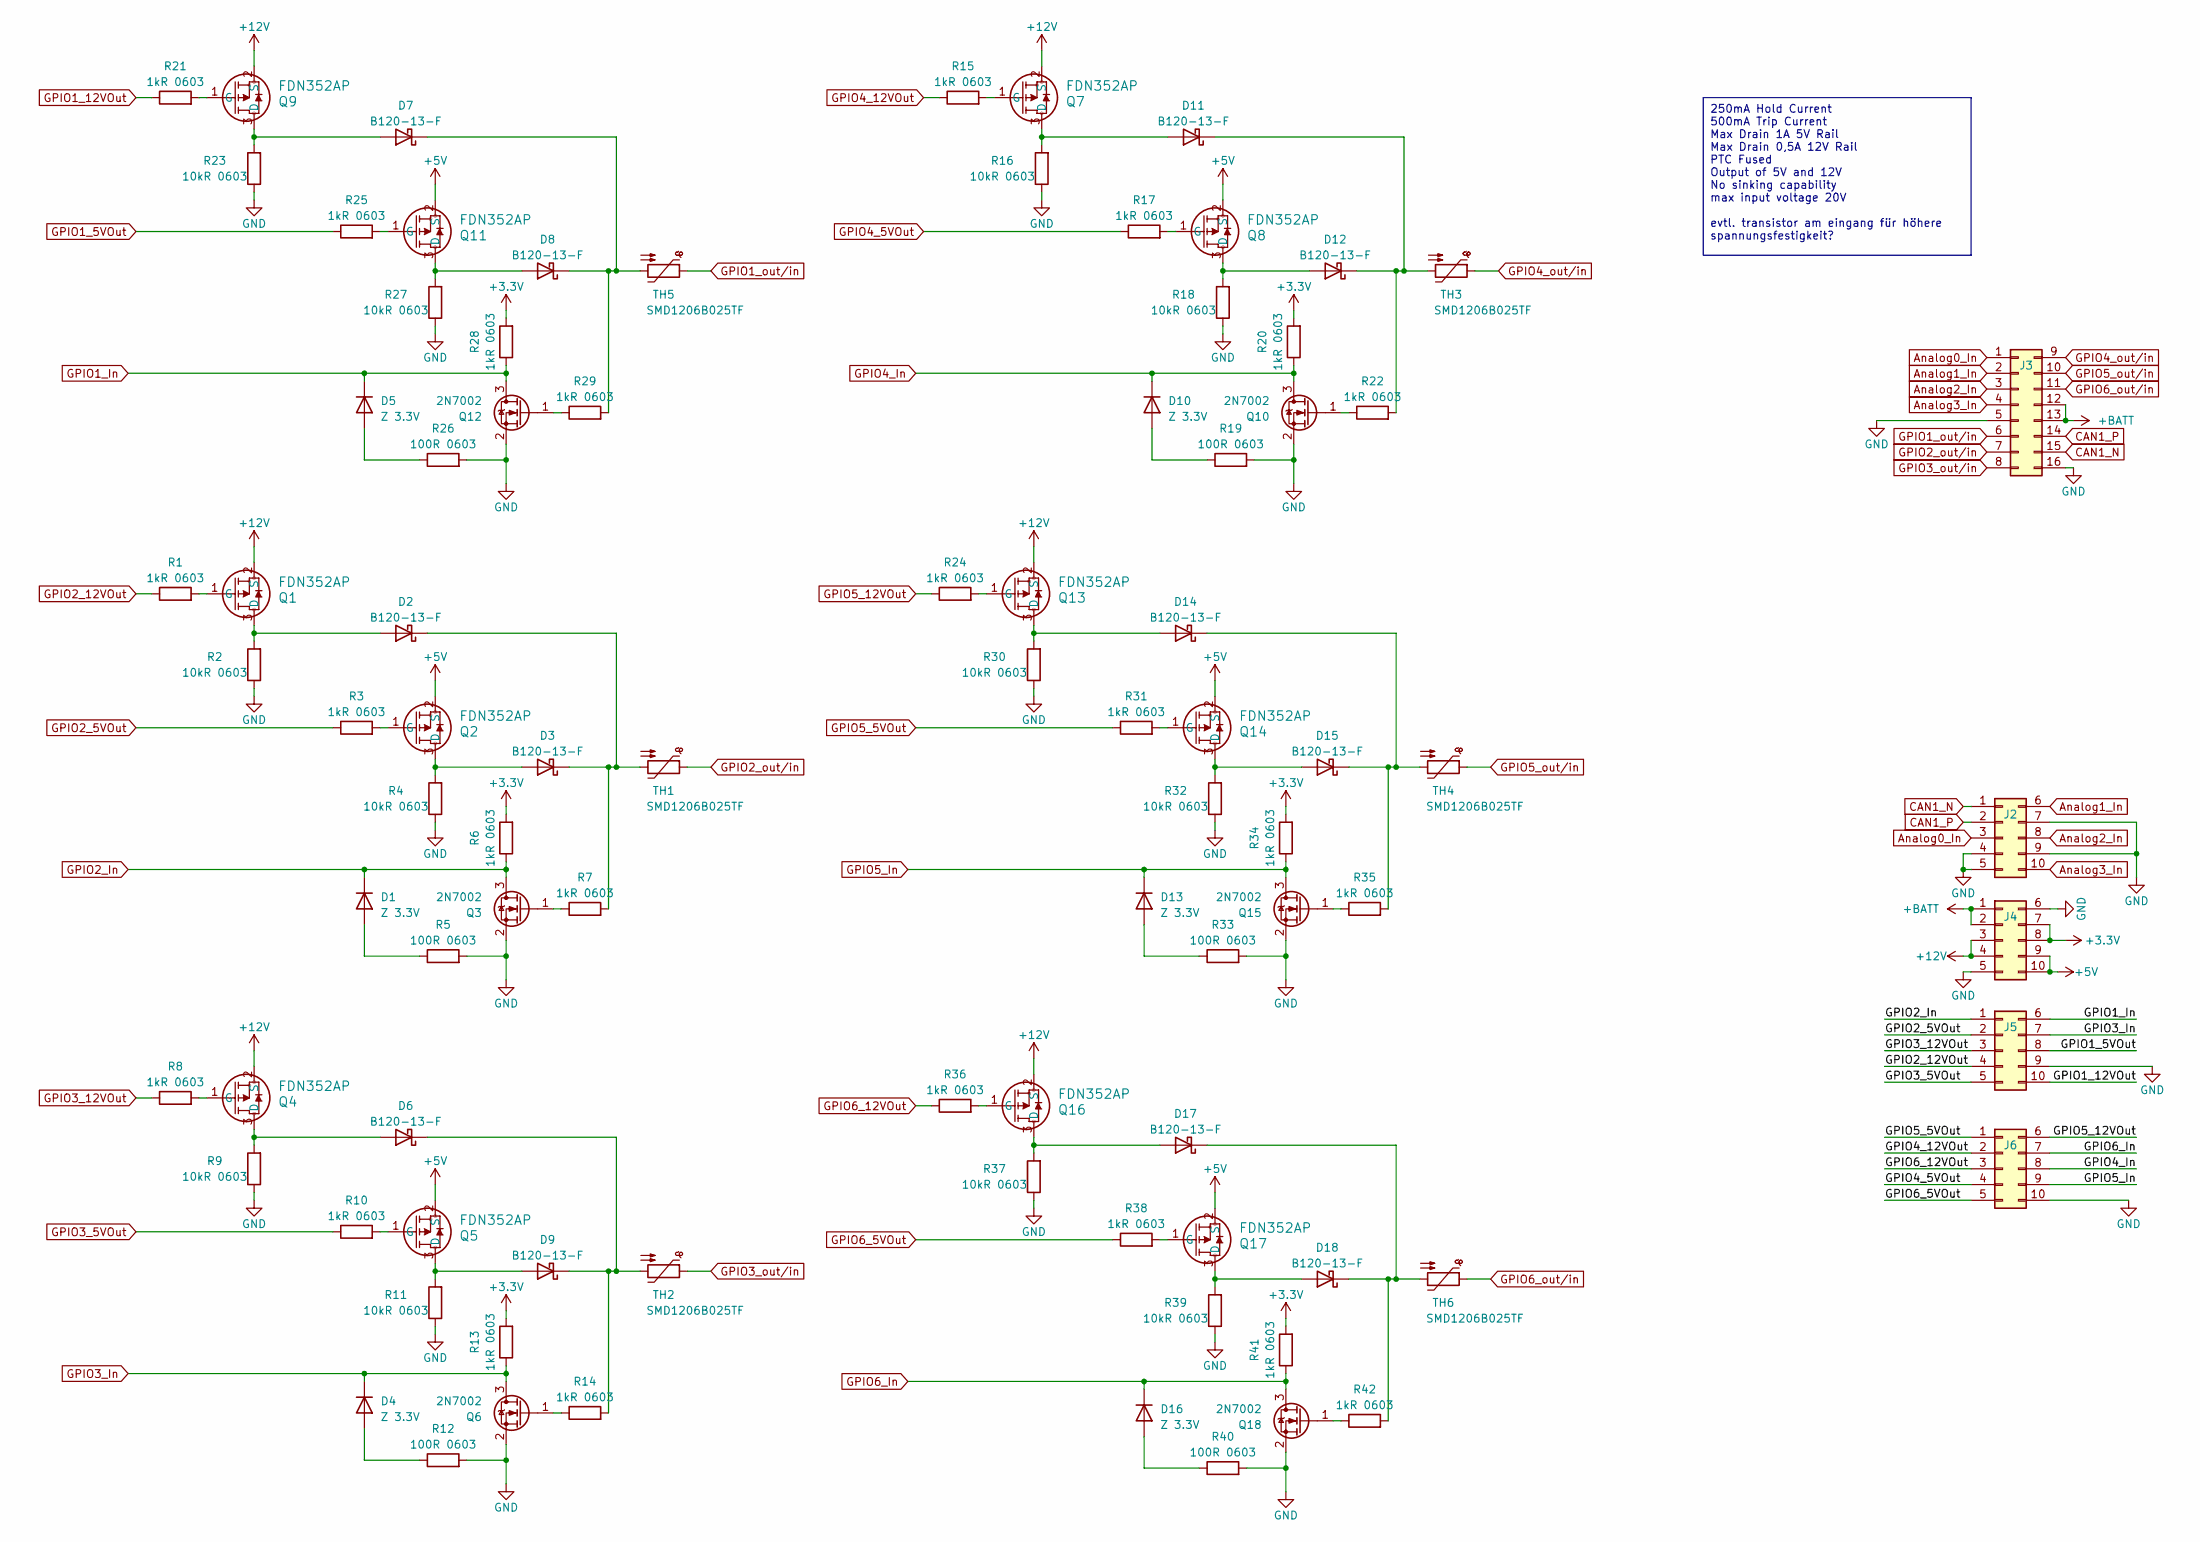
[picture p17: schematic DIC_Addon.kicad_sch]

Parts:
D1, D4, D5, D10, D13, D16: Z 3.3V; D_SOD-323_HandSoldering; PartNr. MM3Z3V3T1G
D2, D3, D6, D7, D8, D9, D11, D12, D14, D15, D17, D18: B120-13-F; D_SMA
J2, J4, J5, J6: Conn_02x05_Top_Bottom; PinSocket_2x05_P1.27mm_Vertical
J3: WE 62702621621; PinHeader_2x08_P1.27mm_Vertical
Q1, Q2, Q4, Q5, Q7, Q8, Q9, Q11, Q13, Q14, Q16, Q17: FDN352AP; SOT23_527AG_ONS
Q3, Q6, Q10, Q12, Q15, Q18: 2N7002; SOT-23
R1, R3, R6, R7, R8, R10, R13, R14, R15, R17, R20, R21, R22, R24, R25, R28, R29, R31, R34, R35, R36, R38, R41, R42: 1kR 0603; R_0603_1608Metric_Pad0.98x0.95mm_HandSolder
R2, R4, R9, R11, R16, R18, R23, R27, R30, R32, R37, R39: 10kR 0603; R_0603_1608Metric_Pad0.98x0.95mm_HandSolder
R5, R12, R19, R26, R33, R40: 100R 0603; R_0603_1608Metric_Pad0.98x0.95mm_HandSolder
TH1, TH2, TH3, TH4, TH5, TH6: SMD1206B025TF; R_1206_3216Metric_Pad1.30x1.75mm_HandSolder

Connections:
+3.3V: J4.7, J4.8, R6.2, R13.2, R20.2, R28.2, R34.2, R41.2
+5V: J4.9, J4.10, Q2.2 (S), Q5.2 (S), Q8.2 (S), Q11.2 (S), Q14.2 (S), Q17.2 (S)
+12V: J4.3, J4.4, Q1.2 (S), Q4.2 (S), Q7.2 (S), Q9.2 (S), Q13.2 (S), Q16.2 (S)
+BATT: J3.12, J3.13, J4.1, J4.2
Analog0_In: J2.3, J3.1
Analog1_In: J2.6, J3.2
Analog2_In: J2.8, J3.3
Analog3_In: J2.10, J3.4
CAN1_N: J2.1, J3.15
CAN1_P: J2.2, J3.14
GND: J2.4, J2.5, J2.7, J2.9, J3.5, J3.16, J4.5, J4.6, J5.9, J6.10, Q3.2 (S), Q6.2 (S), Q10.2 (S), Q12.2 (S), Q15.2 (S), Q18.2 (S), R2.1, R4.1, R5.2, R9.1, R11.1, R12.2, R16.1, R18.1, R19.2, R23.1, R26.2, R27.1, R30.1, R32.1, R33.2, R37.1, R39.1, R40.2
GPIO1_5VOut: J5.8, R25.1
GPIO1_12VOut: J5.10, R21.1
GPIO1_In: D5.1 (K), J5.6, Q12.3 (D), R28.1
GPIO1_out/in: J3.6, TH5.1
GPIO2_5VOut: J5.2, R3.1
GPIO2_12VOut: J5.4, R1.1
GPIO2_In: D1.1 (K), J5.1, Q3.3 (D), R6.1
GPIO2_out/in: J3.7, TH1.1
GPIO3_5VOut: J5.5, R10.1
GPIO3_12VOut: J5.3, R8.1
GPIO3_In: D4.1 (K), J5.7, Q6.3 (D), R13.1
GPIO3_out/in: J3.8, TH2.1
GPIO4_5VOut: J6.4, R17.1
GPIO4_12VOut: J6.2, R15.1
GPIO4_In: D10.1 (K), J6.8, Q10.3 (D), R20.1
GPIO4_out/in: J3.9, TH3.1
GPIO5_5VOut: J6.1, R31.1
GPIO5_12VOut: J6.6, R24.1
GPIO5_In: D13.1 (K), J6.9, Q15.3 (D), R34.1
GPIO5_out/in: J3.10, TH4.1
GPIO6_5VOut: J6.5, R38.1
GPIO6_12VOut: J6.3, R36.1
GPIO6_In: D16.1 (K), J6.7, Q18.3 (D), R41.1
GPIO6_out/in: J3.11, TH6.1
unnamed: D1.2 (A), R5.1
unnamed: D2.2 (A), Q1.3 (D), R2.2
unnamed: D2.1 (K), D3.1 (K), R7.2, TH1.2
unnamed: D3.2 (A), Q2.3 (D), R4.2
unnamed: D4.2 (A), R12.1
unnamed: D5.2 (A), R26.1
unnamed: D6.2 (A), Q4.3 (D), R9.2
unnamed: D6.1 (K), D9.1 (K), R14.2, TH2.2
unnamed: D7.2 (A), Q9.3 (D), R23.2
unnamed: D7.1 (K), D8.1 (K), R29.2, TH5.2
unnamed: D8.2 (A), Q11.3 (D), R27.2
unnamed: D9.2 (A), Q5.3 (D), R11.2
unnamed: D10.2 (A), R19.1
unnamed: D11.2 (A), Q7.3 (D), R16.2
unnamed: D11.1 (K), D12.1 (K), R22.2, TH3.2
unnamed: D12.2 (A), Q8.3 (D), R18.2
unnamed: D13.2 (A), R33.1
unnamed: D14.2 (A), Q13.3 (D), R30.2
unnamed: D14.1 (K), D15.1 (K), R35.2, TH4.2
unnamed: D15.2 (A), Q14.3 (D), R32.2
unnamed: D16.2 (A), R40.1
unnamed: D17.2 (A), Q16.3 (D), R37.2
unnamed: D17.1 (K), D18.1 (K), R42.2, TH6.2
unnamed: D18.2 (A), Q17.3 (D), R39.2
unnamed: Q1.1 (G), R1.2
unnamed: Q2.1 (G), R3.2
unnamed: Q3.1 (G), R7.1
unnamed: Q4.1 (G), R8.2
unnamed: Q5.1 (G), R10.2
unnamed: Q6.1 (G), R14.1
unnamed: Q7.1 (G), R15.2
unnamed: Q8.1 (G), R17.2
unnamed: Q9.1 (G), R21.2
unnamed: Q10.1 (G), R22.1
unnamed: Q11.1 (G), R25.2
unnamed: Q12.1 (G), R29.1
unnamed: Q13.1 (G), R24.2
unnamed: Q14.1 (G), R31.2
unnamed: Q15.1 (G), R35.1
unnamed: Q16.1 (G), R36.2
unnamed: Q17.1 (G), R38.2
unnamed: Q18.1 (G), R42.1

Notes on the sheet:
250mA Hold Current 500mA Trip Current Max Drain 1A 5V Rail Max Drain 0,5A 12V Rail PTC Fused Output of 5V and 12V No sinking capability max input voltage 20V evtl. transistor am eingang für höhere spannungsfestigkeit?

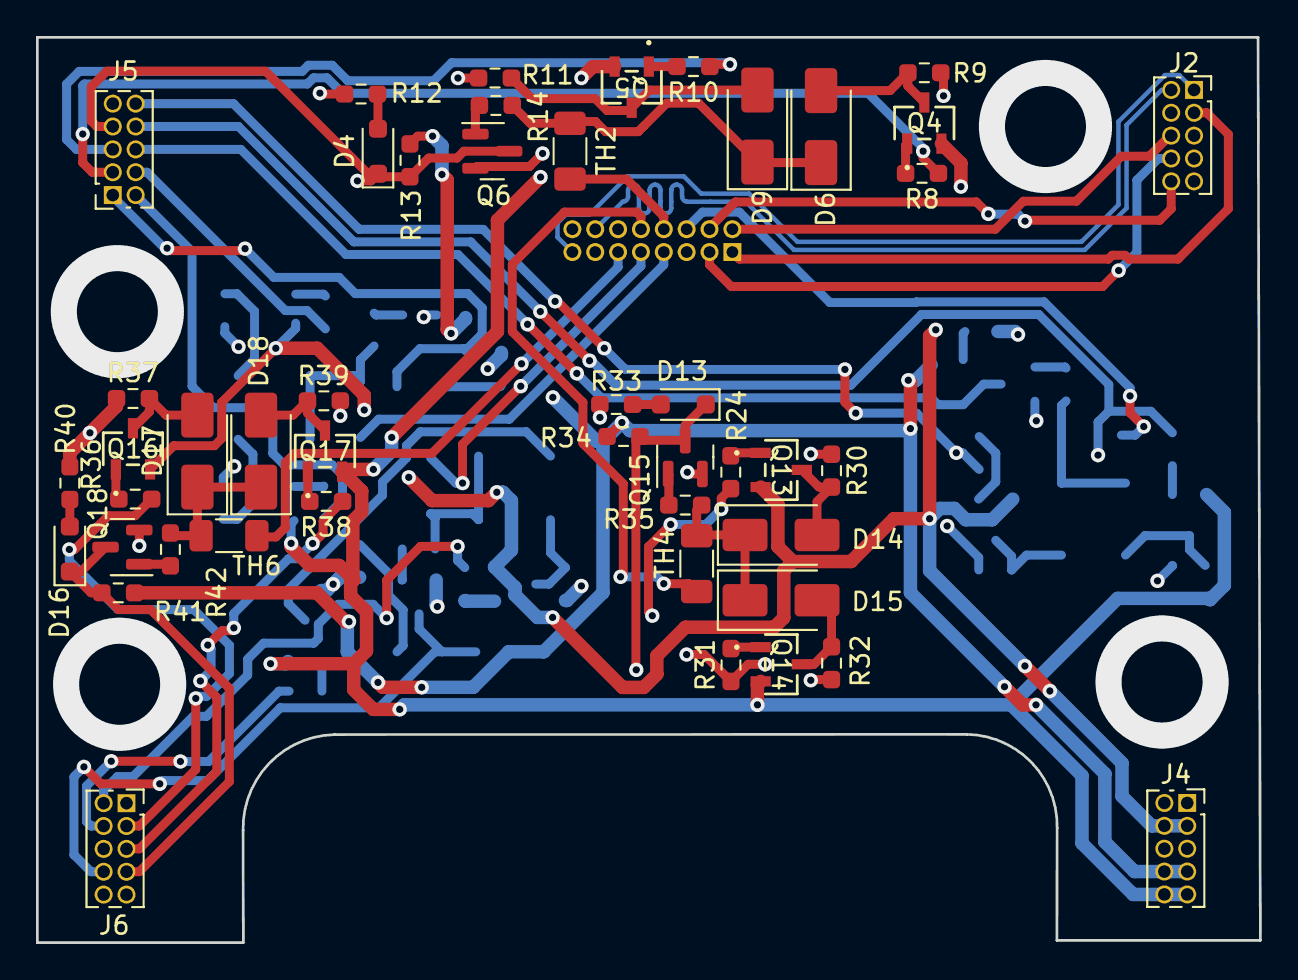
[picture p18: board DIC_Addon.kicad_pcb from above]

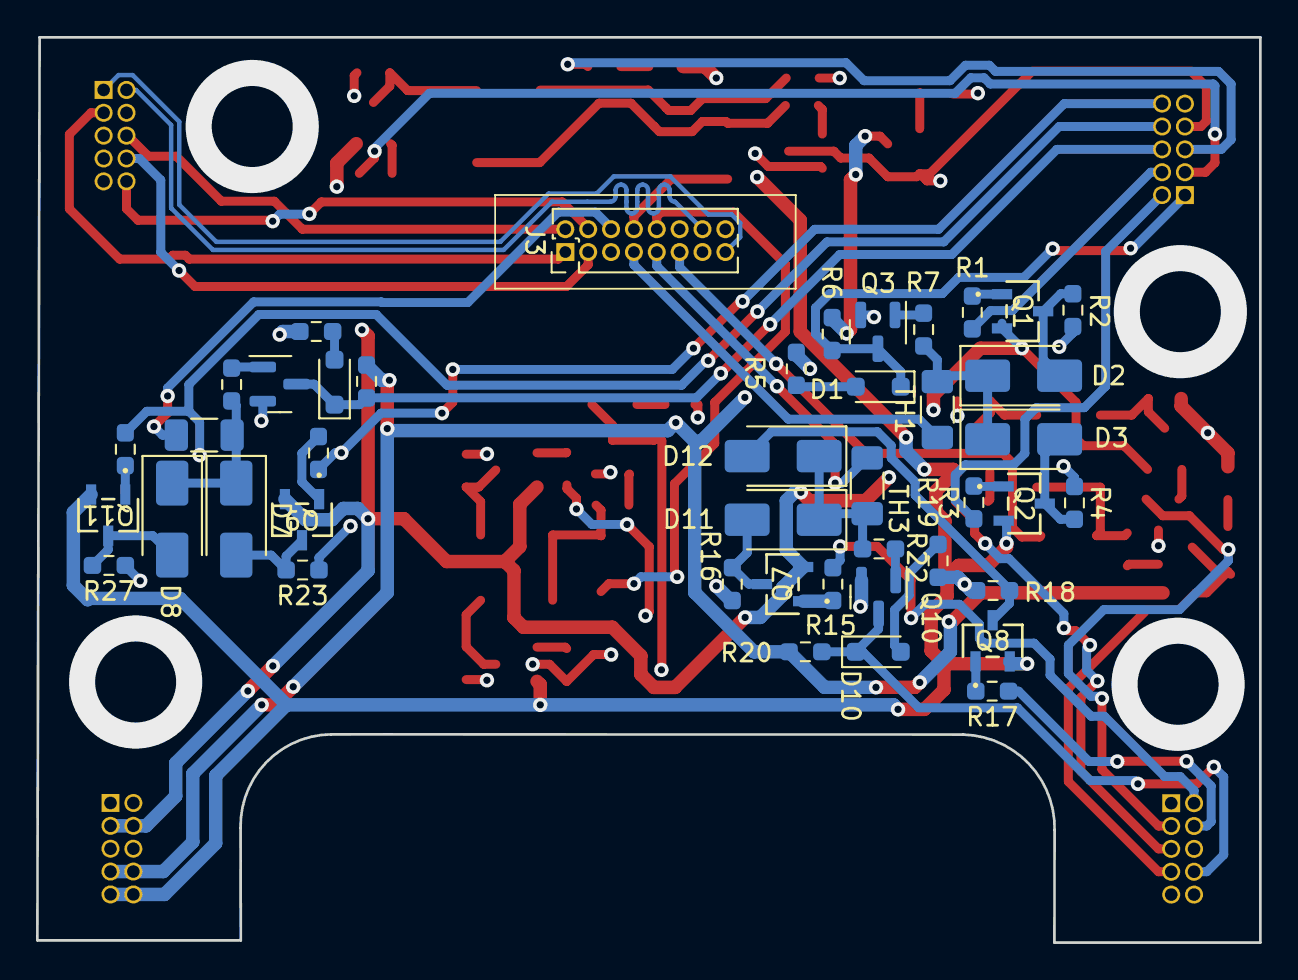
[picture p19: board DIC_Addon.kicad_pcb from below]

Board: 4 copper layers, 67.9 x 50.3 mm, 89 parts (43 on the bottom side), 77 nets.
