Riddick-ulous/DICV3/ECAD/LED_Ring/LED_Ring.kicad_pcb

## KiCad design ECAD/LED_Ring/LED_Ring.kicad_pcb (2025-03-22)

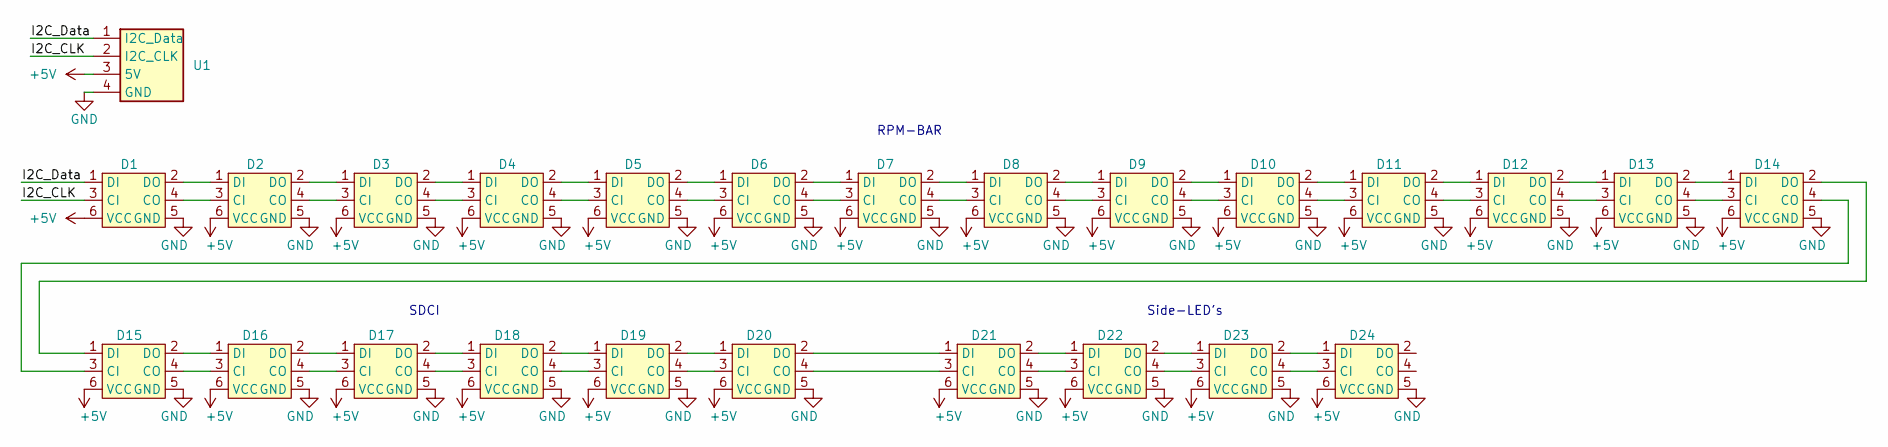
[picture p20: schematic LED_Ring.kicad_sch]

Parts:
D1, D2, D3, D4, D5, D6, D7, D8, D9, D10, D11, D12, D13, D14, D15, D16, D17, D18, D19, D20, D21, D22, D23, D24: BB-2020BGR-TRB
U1: LED_Ring

Connections:
+5V: D1.6 (VCC), D2.6 (VCC), D3.6 (VCC), D4.6 (VCC), D5.6 (VCC), D6.6 (VCC), D7.6 (VCC), D8.6 (VCC), D9.6 (VCC), D10.6 (VCC), D11.6 (VCC), D12.6 (VCC), D13.6 (VCC), D14.6 (VCC), D15.6 (VCC), D16.6 (VCC), D17.6 (VCC), D18.6 (VCC), D19.6 (VCC), D20.6 (VCC), D21.6 (VCC), D22.6 (VCC), D23.6 (VCC), D24.6 (VCC), U1.3 (5V)
/I2C_CLK: D1.3 (CI), U1.2 (I2C_CLK)
/I2C_Data: D1.1 (DI), U1.1 (I2C_Data)
GND: D1.5 (GND), D2.5 (GND), D3.5 (GND), D4.5 (GND), D5.5 (GND), D6.5 (GND), D7.5 (GND), D8.5 (GND), D9.5 (GND), D10.5 (GND), D11.5 (GND), D12.5 (GND), D13.5 (GND), D14.5 (GND), D15.5 (GND), D16.5 (GND), D17.5 (GND), D18.5 (GND), D19.5 (GND), D20.5 (GND), D21.5 (GND), D22.5 (GND), D23.5 (GND), D24.5 (GND), U1.4 (GND)
unnamed: D1.4 (CO), D2.3 (CI)
unnamed: D1.2 (DO), D2.1 (DI)
unnamed: D2.4 (CO), D3.3 (CI)
unnamed: D2.2 (DO), D3.1 (DI)
unnamed: D3.4 (CO), D4.3 (CI)
unnamed: D3.2 (DO), D4.1 (DI)
unnamed: D4.4 (CO), D5.3 (CI)
unnamed: D4.2 (DO), D5.1 (DI)
unnamed: D5.4 (CO), D6.3 (CI)
unnamed: D5.2 (DO), D6.1 (DI)
unnamed: D6.4 (CO), D7.3 (CI)
unnamed: D6.2 (DO), D7.1 (DI)
unnamed: D7.4 (CO), D8.3 (CI)
unnamed: D7.2 (DO), D8.1 (DI)
unnamed: D8.4 (CO), D9.3 (CI)
unnamed: D8.2 (DO), D9.1 (DI)
unnamed: D9.4 (CO), D10.3 (CI)
unnamed: D10.4 (CO), D11.3 (CI)
unnamed: D9.2 (DO), D10.1 (DI)
unnamed: D10.2 (DO), D11.1 (DI)
unnamed: D11.4 (CO), D12.3 (CI)
unnamed: D11.2 (DO), D12.1 (DI)
unnamed: D12.4 (CO), D13.3 (CI)
unnamed: D12.2 (DO), D13.1 (DI)
unnamed: D13.4 (CO), D14.3 (CI)
unnamed: D13.2 (DO), D14.1 (DI)
unnamed: D14.4 (CO), D15.3 (CI)
unnamed: D14.2 (DO), D15.1 (DI)
unnamed: D15.4 (CO), D16.3 (CI)
unnamed: D15.2 (DO), D16.1 (DI)
unnamed: D16.4 (CO), D17.3 (CI)
unnamed: D16.2 (DO), D17.1 (DI)
unnamed: D17.4 (CO), D18.3 (CI)
unnamed: D17.2 (DO), D18.1 (DI)
unnamed: D18.4 (CO), D19.3 (CI)
unnamed: D18.2 (DO), D19.1 (DI)
unnamed: D19.4 (CO), D20.3 (CI)
unnamed: D19.2 (DO), D20.1 (DI)
unnamed: D20.4 (CO), D21.3 (CI)
unnamed: D20.2 (DO), D21.1 (DI)
unnamed: D21.4 (CO), D22.3 (CI)
unnamed: D21.2 (DO), D22.1 (DI)
unnamed: D22.4 (CO), D23.3 (CI)
unnamed: D22.2 (DO), D23.1 (DI)
unnamed: D23.4 (CO), D24.3 (CI)
unnamed: D23.2 (DO), D24.1 (DI)

Notes on the sheet:
Side-LED's
SDCI
RPM-BAR

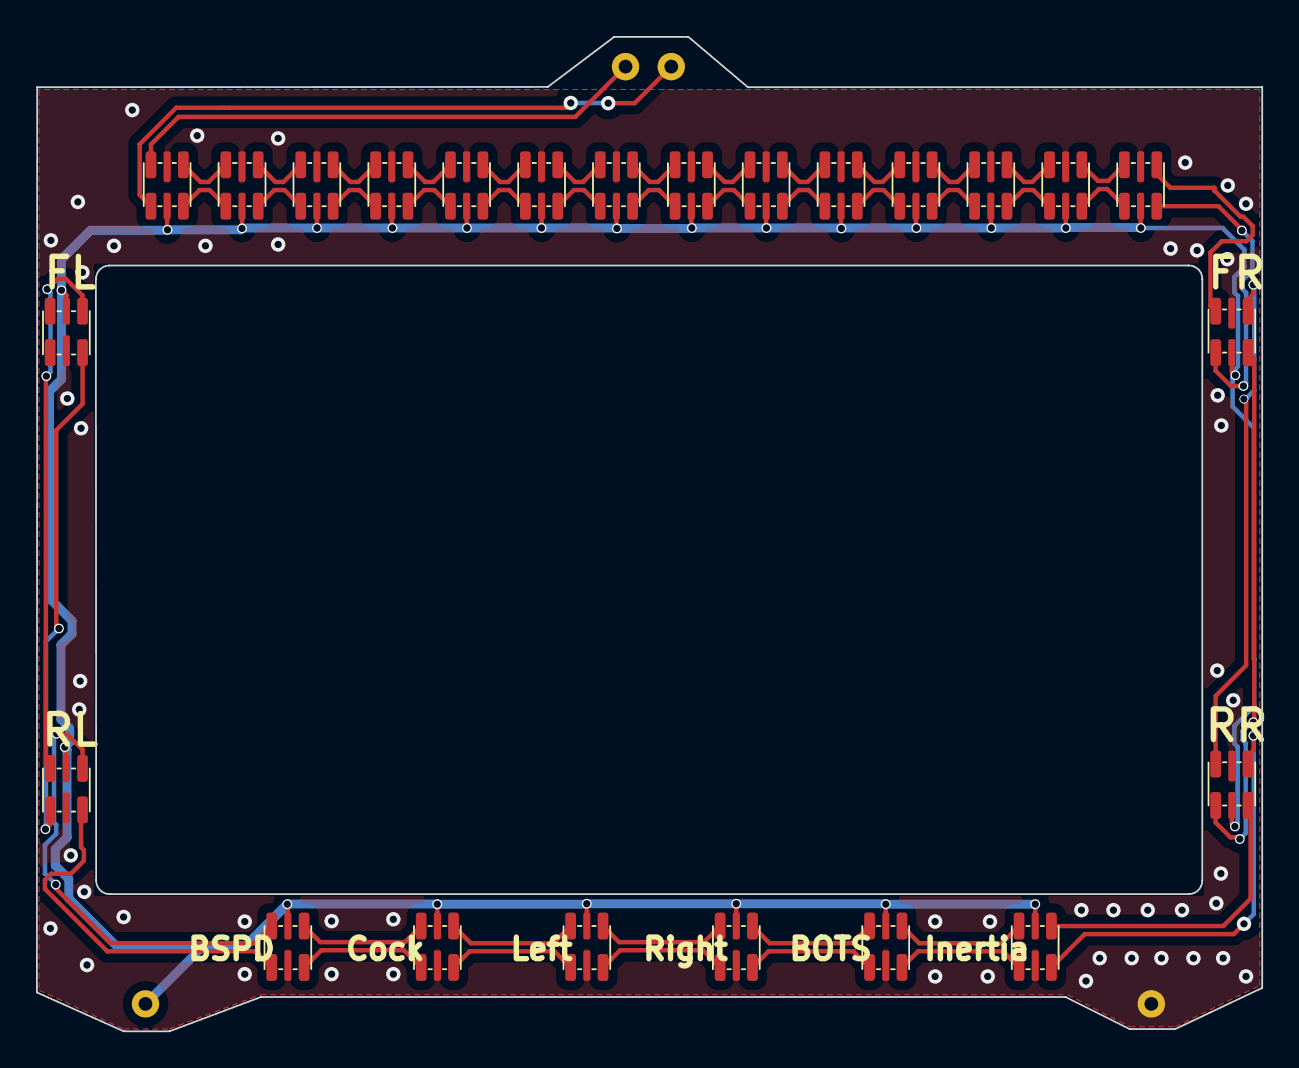
[picture p21: board LED_Ring.kicad_pcb from above]

Board: 2 copper layers, 68.1 x 55.2 mm, 25 parts (0 on the bottom side), 50 nets.
