Riddick-ulous/DICV3/Firmware/Core/Src/main.c

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
/* Includes ------------------------------------------------------------------*/
#include "main.h"

/* USER CODE BEGIN Includes */
#include "CAN.h"
#include "ERROR.h"
#include <stdio.h>
#include "ssd1306.h"
#include "ssd1306_fonts.h"
#include "RGBLED.h"
#include "LOOP_TIMER.h"
#include "ADC.h"
#include "RGBLED.h"
#include "DISPLAYFUN.h"
#include "BootLogo.h"
/* USER CODE END Includes */

ADC_HandleTypeDef hadc;
DMA_HandleTypeDef hdma_adc;

CAN_HandleTypeDef hcan;

SPI_HandleTypeDef hspi1;
SPI_HandleTypeDef hspi2;

TIM_HandleTypeDef htim2;

/* USER CODE BEGIN PV */
extern volatile unsigned long systime;
CAN_Message_t CANmsg;
/*
unsigned long time_old_10ms = 0;
uint8_t sys_10ms_cycle_cplt = 0;
unsigned long time_old_100ms = 0;
uint8_t sys_100ms_cycle_cplt = 0;
unsigned long time_old_200ms = 0;
uint8_t sys_200ms_cycle_cplt = 0;
*/
/* USER CODE END PV */

void SystemClock_Config(void);
static void MX_GPIO_Init(void);
static void MX_DMA_Init(void);
static void MX_CAN_Init(void);
static void MX_SPI1_Init(void);
static void MX_ADC_Init(void);
static void MX_SPI2_Init(void);
static void MX_TIM2_Init(void);
/**
  * @brief  The application entry point.
  * @retval int
  */
int main(void)
{
  /* MCU Configuration--------------------------------------------------------*/

  /* Reset of all peripherals, Initializes the Flash interface and the Systick. */
  HAL_Init();

  /* Configure the system clock */
  SystemClock_Config();

  /* Initialize all configured peripherals */
  MX_GPIO_Init();
  MX_DMA_Init();
  MX_CAN_Init();
  MX_SPI1_Init();
  MX_ADC_Init();
  MX_SPI2_Init();
  MX_TIM2_Init();
  /* USER CODE BEGIN 2 */
  HAL_ADCEx_Calibration_Start(&hadc);
  HAL_TIM_Base_Start(&htim2);
  RGBLED_Init();
  ADC_Init();

  CAN_RegisterRxCallback(RGBLED_HandleCAN);
  CAN_RegisterRxCallback(ADC_HandleCAN);
  CAN_RegisterRxCallback(DISP_HandleCAN);
  /* USER CODE END 2 */

  /* Infinite loop */
  /* USER CODE BEGIN WHILE */

/*
  ssd1306_Init();
  ssd1306_Fill(White);
  ssd1306_DrawPixel(2, 2, Black);
  ssd1306_DrawPixel(1, 1, Black);
  ssd1306_DrawPixel(0, 0, Black);
  ssd1306_UpdateScreen();
  ssd1306_Fill(Black);
  ssd1306_SetCursor(0, 0);
  ssd1306_WriteString("Hello World", Font_6x8, White);
  ssd1306_UpdateScreen();
*/

  DISP_Init();
  DISP_GoHome();

  HAL_GPIO_WritePin(GPIO1_12VOut_GPIO_Port,GPIO1_12VOut_Pin, GPIO_PIN_RESET);
  HAL_GPIO_WritePin(GPIO1_5VOut_GPIO_Port,GPIO1_5VOut_Pin, GPIO_PIN_RESET);

  HAL_GPIO_WritePin(ADC1_CTRL_GPIO_Port,ADC1_CTRL_Pin, GPIO_PIN_SET);
  HAL_GPIO_WritePin(ADC1_NTC_CTRL_GPIO_Port,ADC1_NTC_CTRL_Pin, GPIO_PIN_RESET);

  // Loops anlegen + 0-init
  loop_timer_t loop_1ms   = {0};
  loop_timer_t loop_10ms  = {0};
  loop_timer_t loop_100ms = {0};
  loop_timer_t loop_200ms = {0};

  void init_loops(void)
  {
      loop_init(&loop_1ms,   1,   NULL);
      loop_init(&loop_10ms,  10,  &loop_1ms);
      loop_init(&loop_100ms, 100, &loop_10ms);
      loop_init(&loop_200ms, 200, &loop_100ms);
  }

  init_loops();

  DISP_ShowBootLogoEx(boot_logo, BOOT_LOGO_W, BOOT_LOGO_H,
		  /*invert=*/false,
          /*xbm_row_major=*/false,
          /*xbm_msb_first=*/false);
  HAL_Delay(3000);

  while (1)
  {

	    uint32_t systime = HAL_GetTick();

	  	  // --- 1 ms Loop ---
	  	  if (loop_due(&loop_1ms, systime)) {
	  		  loop_start(&loop_1ms, systime);
	  		  // 1ms-Tasks hier
	  		  loop_end(&loop_1ms, ERROR_LOOP_OVERRUN_1MS);
	  	  }

	  	// --- 10 ms Loop ---
	  	    if (loop_due(&loop_10ms, systime)) {
	  	        loop_start(&loop_10ms, systime);


				// Senden der Loop usages
				// Nachricht vorbereiten
				CANmsg.id = 0x100;
				CANmsg.dlc = 8;
				CANmsg.data[0] = loop_1ms.max_prev_x10  & 0xFF; CANmsg.data[1] = loop_1ms.max_prev_x10  >> 8;
				CANmsg.data[2] = loop_10ms.max_prev_x10 & 0xFF; CANmsg.data[3] = loop_10ms.max_prev_x10 >> 8;
				CANmsg.data[4] = loop_100ms.max_prev_x10& 0xFF; CANmsg.data[5] = loop_100ms.max_prev_x10>> 8;
				CANmsg.data[6] = loop_200ms.max_prev_x10& 0xFF; CANmsg.data[7] = loop_200ms.max_prev_x10>> 8;

				if (CAN_QueueMessage(&CANmsg) != HAL_OK)
				{
				   Error_Register(ERROR_CAN_QUEUE_FULL);
				}

	  	        // ADC-Werte holen (gemittelt)
				uint16_t ch0 = ADC_GetAverage(0);
				uint16_t ch1 = ADC_GetAverage(1);
				uint16_t ch2 = ADC_GetAverage(2);
				uint16_t ch3 = ADC_GetAverage(3);

				// CAN-Nachricht vorbereiten
				CANmsg.id  = 0x101;   // frei wählen
				CANmsg.dlc = 8;
				CANmsg.data[0] = ch0 & 0xFF;
				CANmsg.data[1] = ch0 >> 8;
				CANmsg.data[2] = ch1 & 0xFF;
				CANmsg.data[3] = ch1 >> 8;
				CANmsg.data[4] = ch2 & 0xFF;
				CANmsg.data[5] = ch2 >> 8;
				CANmsg.data[6] = ch3 & 0xFF;
				CANmsg.data[7] = ch3 >> 8;

				if (CAN_QueueMessage(&CANmsg) != HAL_OK)
				{
				   Error_Register(ERROR_CAN_QUEUE_FULL);
				}

				RGBLED_TimeoutCheck(systime, &hspi2);

				DISP_Render();

	  	      loop_end(&loop_10ms, ERROR_LOOP_OVERRUN_10MS);
	  	    }

	  	    // --- 100 ms Loop ---
	  	    if (loop_due(&loop_100ms, systime)) {
	  	        loop_start(&loop_100ms, systime);

	  	      // Page 0 befüllen
	  	      DISP_SetPage(0);
	  	      DISP_WriteLabel(0, 0, "Hello World");
	  	      DISP_WriteNumber(1234, 2, 6, 1, 0, "V");     // → "  12.34V" bei min_width=6
	  	      DISP_WriteLapTime(90567, 2, 0);              // → "1:30.567"

			  //RGBLED_TestPattern();
			  //RGBLED_Update(&hspi2);

			  CAN_Message_t* received = CAN_GetMessage(0x321);
			  uint16_t value = 0;

			  if (received && received->dlc >= 2) {
			      value = (uint16_t)received->data[0] | ((uint16_t)received->data[1] << 8);
			  } else {
			      Error_Register(ERROR_CAN_RX_EMPTY);
			  }

	  	      DISP_SetPage(0);
	  	      DISP_WriteNumber(value, 0, 6, 4, 0, "-");     // → "  12.34V" bei min_width=6
	  	      /*
			  ssd1306_SetCursor(0, 8);
			  ssd1306_WriteString(buffer, Font_6x8, White);
	  	      */
			  Display_ErrorStatus(0, 3, 0);

			  //ssd1306_UpdateScreen();

			  ADC_SendCurrentConfig();

			  loop_end(&loop_100ms, ERROR_LOOP_OVERRUN_100MS);
		}

			// --- 200 ms Loop ---
			if (loop_due(&loop_200ms, systime)) {
				loop_start(&loop_200ms, systime);

	  		  HAL_GPIO_TogglePin(Heart_GPIO_Port,Heart_Pin);
	  		  Error_LED_Update();  // LED-Steuerung hier

	  		loop_end(&loop_200ms, ERROR_LOOP_OVERRUN_200MS);
		}
    /* USER CODE END WHILE */

    /* USER CODE BEGIN 3 */

  // While(1) Klammer below
  }
  // Main Klammer below
  /* USER CODE END 3 */
}

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
