Riddick-ulous/DICV3/Firmware/Core/Inc/BootLogo.h

/*
 * BootLogo.h
 *
 *  Created on: Aug 12, 2025
 *      Author: lukas
 */

extern const uint8_t boot_logo[]; // dein Array
// width/height notieren:
#define BOOT_LOGO_W 128
#define BOOT_LOGO_H 49

const uint8_t boot_logo[] = {
   0xff, 0x01, 0x70, 0x00, 0x03, 0xfe, 0x3f, 0x07, 0xf8, 0x00, 0xfc, 0xff,
   0xff, 0xff, 0x03, 0x00, 0xff, 0x07, 0x70, 0x00, 0x03, 0xfe, 0x3f, 0x07,
   0xfe, 0x01, 0xfc, 0xff, 0xff, 0xff, 0x1f, 0x00, 0xff, 0x0f, 0x70, 0x00,
   0x03, 0xfe, 0x3f, 0x07, 0xff, 0x03, 0xfc, 0xff, 0xff, 0xff, 0xff, 0x00,
   0x07, 0x0e, 0xf8, 0x00, 0x03, 0xc0, 0x01, 0x87, 0x87, 0x07, 0xfc, 0xff,
   0xff, 0xff, 0xff, 0x01, 0x07, 0x0e, 0xd8, 0x00, 0x03, 0xc0, 0x01, 0x87,
   0x03, 0x07, 0xfc, 0xff, 0xff, 0xff, 0xff, 0x07, 0x07, 0x0e, 0xd8, 0x01,
   0x03, 0xc0, 0x01, 0x87, 0x03, 0x00, 0xfc, 0xff, 0xff, 0xff, 0xff, 0x0f,
   0x07, 0x0e, 0xdc, 0x01, 0x03, 0xc0, 0x01, 0xc7, 0x03, 0x00, 0xfc, 0xff,
   0xff, 0xff, 0xff, 0x1f, 0x07, 0x07, 0x8c, 0x01, 0x03, 0xc0, 0x01, 0xc7,
   0x01, 0x00, 0xfc, 0xff, 0xff, 0xff, 0xff, 0x1f, 0xff, 0x03, 0x8e, 0x03,
   0x03, 0xc0, 0x01, 0xc7, 0x01, 0x00, 0xfc, 0xff, 0xff, 0xff, 0xff, 0x3f,
   0xff, 0x07, 0x8e, 0x03, 0x03, 0xc0, 0x01, 0xc7, 0x01, 0x00, 0xfc, 0xff,
   0xff, 0xff, 0xff, 0x3f, 0x07, 0x0e, 0x06, 0x03, 0x03, 0xc0, 0x01, 0xc7,
   0x01, 0x00, 0xfc, 0xff, 0xff, 0xff, 0xff, 0x7f, 0x07, 0x0e, 0xff, 0x07,
   0x03, 0xc0, 0x01, 0xc7, 0x03, 0x00, 0xfc, 0xff, 0xff, 0xff, 0xff, 0x7f,
   0x07, 0x0c, 0xff, 0x07, 0x03, 0xc0, 0x01, 0x87, 0x03, 0x00, 0xfc, 0xff,
   0xff, 0xff, 0xff, 0x7f, 0x07, 0x0c, 0xff, 0x07, 0x03, 0xc0, 0x01, 0x87,
   0x03, 0x07, 0xfc, 0xff, 0xff, 0xff, 0xff, 0xff, 0x07, 0x8e, 0x03, 0x0e,
   0x03, 0xc0, 0x01, 0x87, 0x87, 0x07, 0xfc, 0xff, 0xff, 0xff, 0xff, 0xff,
   0xff, 0x8f, 0x03, 0x0e, 0xff, 0xc7, 0x01, 0x07, 0xff, 0x03, 0xfc, 0xff,
   0xff, 0xff, 0xff, 0xff, 0xff, 0x87, 0x01, 0x1c, 0xff, 0xc7, 0x01, 0x07,
   0xfe, 0x01, 0xfc, 0xff, 0xff, 0xff, 0xff, 0xff, 0xff, 0xc1, 0x01, 0x1c,
   0xff, 0xc7, 0x01, 0x07, 0xf8, 0x00, 0x00, 0x00, 0x78, 0x00, 0x00, 0x00,
   0x00, 0x00, 0x00, 0x00, 0x00, 0x00, 0x00, 0x00, 0x00, 0x00, 0x00, 0x00,
   0x3c, 0x00, 0x00, 0x00, 0x00, 0x00, 0x00, 0x00, 0x00, 0x00, 0x00, 0x00,
   0x00, 0x00, 0x00, 0x00, 0x3c, 0x00, 0x00, 0x00, 0x00, 0x00, 0x00, 0x00,
   0x00, 0x00, 0x00, 0x00, 0x00, 0x00, 0x00, 0x00, 0x1e, 0x00, 0x00, 0x00,
   0xff, 0x01, 0x60, 0x00, 0xf8, 0x81, 0x83, 0x03, 0x0e, 0xf0, 0x01, 0x00,
   0xfe, 0xff, 0xff, 0x7f, 0xff, 0x07, 0xf0, 0x00, 0xfc, 0x83, 0x83, 0x03,
   0x0e, 0xf8, 0x07, 0x00, 0xff, 0xff, 0xff, 0x3f, 0xff, 0x0f, 0xf0, 0x00,
   0xfe, 0x87, 0x83, 0x07, 0x0e, 0xfc, 0x0f, 0x00, 0xff, 0xff, 0xff, 0x3f,
   0x07, 0x0e, 0xf0, 0x00, 0x0f, 0x8f, 0x83, 0x0f, 0x0e, 0x0e, 0x0e, 0x80,
   0xff, 0xff, 0xff, 0x1f, 0x07, 0x0c, 0xf8, 0x01, 0x07, 0x8e, 0x83, 0x0f,
   0x0e, 0x0e, 0x1c, 0x80, 0xff, 0xff, 0xff, 0x1f, 0x07, 0x0c, 0x98, 0x01,
   0x07, 0x80, 0x83, 0x1f, 0x0e, 0x06, 0x00, 0xc0, 0xff, 0xff, 0xff, 0x0f,
   0x07, 0x0e, 0x98, 0x01, 0x03, 0x80, 0x83, 0x1f, 0x0e, 0x07, 0x00, 0xc0,
   0xff, 0xff, 0xff, 0x0f, 0x07, 0x0f, 0x9c, 0x03, 0x03, 0x80, 0x83, 0x3b,
   0x0e, 0x03, 0x00, 0xe0, 0xff, 0xff, 0xff, 0x07, 0xff, 0x07, 0x0c, 0x03,
   0x03, 0x80, 0x83, 0x73, 0x0e, 0x83, 0x1f, 0xe0, 0xff, 0xff, 0xff, 0x07,
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
