Riddick-ulous/DICV3/(commit log)

2025-02-17 initial commit for baseline PCB and Firmware, WIP
    [Analog.kicad_sch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]
2025-02-18 Finish Schematic for V3 PCB
    [Analog.kicad_sch, DIC.kicad_sch, DIC_Addon.kicad_sch]
2025-03-22 switch to ribbon cable pcb interconnect
    [ADCFrontendCalc.ods, Analog.kicad_sch, DIC.kicad_pcb, DIC.kicad_sch, DICAddonBoard.FCStd, DICDispalyBoard.FCStd, DICLEDBoard.FCStd, DICMainboard.FCStd]
2025-03-25 finisjed PCB projekt
    [ConnectorInterfaceBoard.kicad_pcb, ConnectorInterfaceBoard.kicad_sch, DIC.kicad_pcb, DIC.kicad_sch, DICAddonBoard.FCStd, DICMainboard.FCStd, DIC_Addon.FCStd, DIC_Addon.kicad_pcb]
2025-04-17 few small changes
    [Analog.kicad_sch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]
2025-06-22 production ready
    [ConnectorInterfaceBoard-B_Cu.gbr, ConnectorInterfaceBoard-B_Mask.gbr, ConnectorInterfaceBoard-B_Silkscreen.gbr, ConnectorInterfaceBoard-Edge_Cuts.gbr, ConnectorInterfaceBoard-F_Cu.gbr, ConnectorInterfaceBoard-F_Mask.gbr, ConnectorInterfaceBoard-F_Silkscreen.gbr, ConnectorInterfaceBoard-NPTH.drl]
2025-08-10 bunch o SW
    added all baseline code for Display LED, ADC etc.
    [DIC.kicad_sch, DIC_Addon.kicad_sch]
2025-08-10 Muuch SW
    implemted LED via CAN
    ADC config + via can
2025-08-11 DisplayFun
    implement display functions, need to be tested aswell as ADC code
